M0WUT/kicad_libraries/dog-pngrepo-com.png

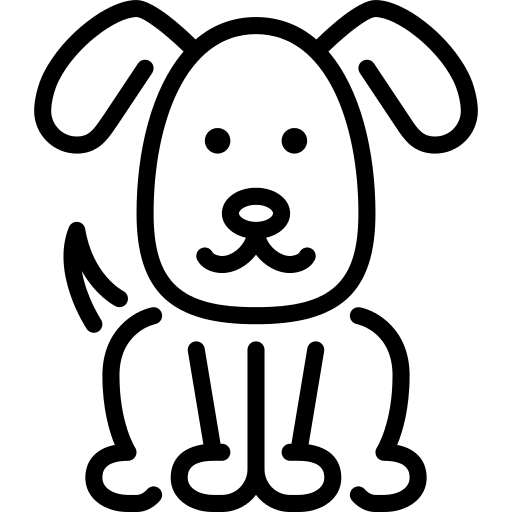
dog-pngrepo-com.png
