M0WUT/kicad_libraries/monocle.png

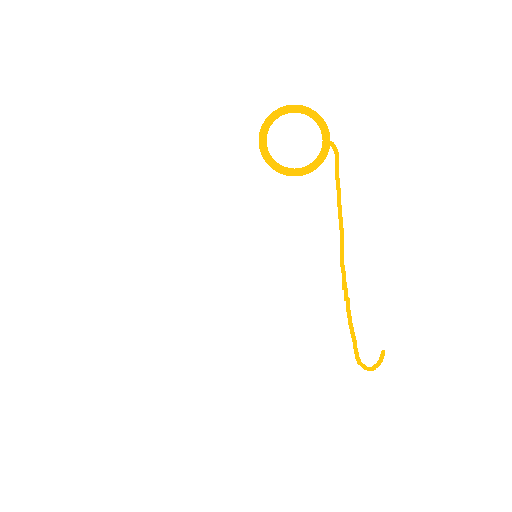
monocle.png
