M0WUT/kicad_libraries/scripts/autogenerated_parts.xlsx

Sheet: capacitor
Manufacturer | MPN | Value | Preferred | Package Description | Footprint | Max Height (mm) | Tolerance (%) | Datasheet | Polarised? | Voltage | Dielectric
Yageo | CC0402KRX7R8BB104 | 100n | Y | 0402 | Capacitor_SMD:C_0402_1005Metric | 0.5 | 10% | https://www.yageo.com/upload/media/product/productsearch/datasheet/mlcc/UPY-GPHC_X7R_6.3V-to-250V_23.pdf | N | 25V | X7R
Kyocera AVX | 12063D226KAT2A | 22u | N | 1206 | Capacitor_SMD:C_1206_3216Metric | 2.29 | 10% | https://www.farnell.com/datasheets/3673819.pdf | N | 25V | X5R
Kemet | C0603C100C3GACTU | 10p | N | 0603 | Capacitor_SMD:C_0603_1608Metric | 0.8 | 0.25pF | https://www.mouser.co.uk/datasheet/2/212/KEM_C1003_C0G_SMD-1101588.pdf | N | 25V | NP0/C0G
Kemet | C0603C151G1GACTU | 150p | N | 0603 | Capacitor_SMD:C_0603_1608Metric | 0.8 | 2% | https://www.mouser.co.uk/datasheet/2/212/KEM_C1003_C0G_SMD-1101588.pdf | N | 100V | NP0/C0G
Kemet | C0603C162F5GACTU | 1n6 | N | 0603 | Capacitor_SMD:C_0603_1608Metric | 0.8 | 1% | https://www.mouser.co.uk/datasheet/2/212/KEM_C1003_C0G_SMD-1101588.pdf | N | 50V | NP0/C0G
Kemet | C0603C202F5GACTU | 2n | N | 0603 | Capacitor_SMD:C_0603_1608Metric | 0.8 | 1% | https://www.mouser.co.uk/datasheet/2/212/KEM_C1003_C0G_SMD-1101588.pdf | N | 50V | NP0/C0G
Kemet | C0603C519C8GACTU | 5p1 | N | 0603 | Capacitor_SMD:C_0603_1608Metric | 0.8 | 0.25pF | https://www.mouser.co.uk/datasheet/2/212/KEM_C1003_C0G_SMD-1101588.pdf | N | 10V | NP0/C0G
Kemet | C0603C399J5GACTU | 3p9 | N | 0603 | Capacitor_SMD:C_0603_1608Metric | 0.8 | 5% | https://www.mouser.co.uk/datasheet/2/212/KEM_C1003_C0G_SMD-1101588.pdf | N | 50V | NP0/C0G
Kemet | C0603C510F1GACTU | 51p | N | 0603 | Capacitor_SMD:C_0603_1608Metric | 0.8 | 1% | https://www.mouser.co.uk/datasheet/2/212/KEM_C1003_C0G_SMD-1101588.pdf | N | 100V | NP0/C0G
Kemet | C0603C300F5GACTU | 30p | N | 0603 | Capacitor_SMD:C_0603_1608Metric | 0.8 | 1% | https://www.mouser.co.uk/datasheet/2/212/KEM_C1003_C0G_SMD-1101588.pdf | N | 50V | NP0/C0G
Kemet | C0603C430F5GACTU | 43p | N | 0603 | Capacitor_SMD:C_0603_1608Metric | 0.8 | 1% | https://www.mouser.co.uk/datasheet/2/212/KEM_C1003_C0G_SMD-1101588.pdf | N | 50V | NP0/C0G
Kemet | C0603C221G1GACTU | 220p | N | 0603 | Capacitor_SMD:C_0603_1608Metric | 0.8 | 2% | https://www.mouser.co.uk/datasheet/2/212/KEM_C1003_C0G_SMD-1101588.pdf | N | 100V | NP0/C0G
Kemet | C0603C471F1GACTU | 470p | N | 0603 | Capacitor_SMD:C_0603_1608Metric | 0.8 | 1% | https://www.mouser.co.uk/datasheet/2/212/KEM_C1003_C0G_SMD-1101588.pdf | N | 100V | NP0/C0G
Kemet | C0603C681F3GACTU | 680p | N | 0603 | Capacitor_SMD:C_0603_1608Metric | 0.8 | 1% | https://www.mouser.co.uk/datasheet/2/212/KEM_C1003_C0G_SMD-1101588.pdf | N | 25V | NP0/C0G
Kemet | C0603C122F1GACTU | 1n2 | N | 0603 | Capacitor_SMD:C_0603_1608Metric | 0.8 | 1% | https://www.mouser.co.uk/datasheet/2/212/KEM_C1003_C0G_SMD-1101588.pdf | N | 100V | NP0/C0G
Kemet | C0603C242F5GACTU | 2n4 | N | 0603 | Capacitor_SMD:C_0603_1608Metric | 0.8 | 1% | https://www.mouser.co.uk/datasheet/2/212/KEM_C1003_C0G_SMD-1101588.pdf | N | 50V | NP0/C0G
Kemet | C0603C470F1GACTU | 47p | N | 0603 | Capacitor_SMD:C_0603_1608Metric | 0.8 | 1% | https://www.mouser.co.uk/datasheet/2/212/KEM_C1003_C0G_SMD-1101588.pdf | N | 100V | NP0/C0G
Kemet | C0603C220K1GACTU | 22p | N | 0603 | Capacitor_SMD:C_0603_1608Metric | 0.8 | 10% | https://www.mouser.co.uk/datasheet/2/212/KEM_C1003_C0G_SMD-1101588.pdf | N | 100V | NP0/C0G
Kemet | C0603C200G5GACTU | 20p | N | 0603 | Capacitor_SMD:C_0603_1608Metric | 0.8 | 2% | https://www.mouser.co.uk/datasheet/2/212/KEM_C1003_C0G_SMD-1101588.pdf | N | 50V | NP0/C0G
Kemet | C0603C120C5GACTU | 12p | N | 0603 | Capacitor_SMD:C_0603_1608Metric | 0.8 | 0.25pF | https://www.mouser.co.uk/datasheet/2/212/KEM_C1003_C0G_SMD-1101588.pdf | N | 50V | NP0/C0G
Kemet | C0603C180C5GACTU | 18p | N | 0603 | Capacitor_SMD:C_0603_1608Metric | 0.8 | 0.25pF | https://www.mouser.co.uk/datasheet/2/212/KEM_C1003_C0G_SMD-1101588.pdf | N | 50V | NP0/C0G
Kemet | C0603C109B5GACTU | 1p | N | 0603 | Capacitor_SMD:C_0603_1608Metric | 0.8 | 0.1pF | https://www.mouser.co.uk/datasheet/2/212/KEM_C1003_C0G_SMD-1101588.pdf | N | 50V | NP0/C0G
Kemet | C0603C470J5GAC | 47p | N | 0603 | Capacitor_SMD:C_0603_1608Metric | 0.8 | 5% | https://www.mouser.co.uk/datasheet/2/212/KEM_C1003_C0G_SMD-1101588.pdf | N | 50V | NP0/C0G
Kemet | C0603C150G5GACTU | 15p | N | 0603 | Capacitor_SMD:C_0603_1608Metric | 0.8 | 2% | https://www.mouser.co.uk/datasheet/2/212/KEM_C1003_C0G_SMD-1101588.pdf | N | 50V | NP0/C0G
Kemet | C0603C221G3GACTU | 220p | N | 0603 | Capacitor_SMD:C_0603_1608Metric | 0.8 | 2% | https://www.mouser.co.uk/datasheet/2/212/KEM_C1003_C0G_SMD-1101588.pdf | N | 25V | NP0/C0G
Kemet | C0603C201F5GACTU | 200p | N | 0603 | Capacitor_SMD:C_0603_1608Metric | 0.8 | 1% | https://www.mouser.co.uk/datasheet/2/212/KEM_C1003_C0G_SMD-1101588.pdf | N | 50V | NP0/C0G
Kemet | C0603C431F5GACTU | 430p | N | 0603 | Capacitor_SMD:C_0603_1608Metric | 0.8 | 1% | https://www.mouser.co.uk/datasheet/2/212/KEM_C1003_C0G_SMD-1101588.pdf | N | 50V | NP0/C0G
Kemet | C0603C911F5GACTU | 910p | N | 0603 | Capacitor_SMD:C_0603_1608Metric | 0.8 | 1% | https://www.mouser.co.uk/datasheet/2/212/KEM_C1003_C0G_SMD-1101588.pdf | N | 50V | NP0/C0G
Kemet | C0603C621F5GACTU | 620p | N | 0603 | Capacitor_SMD:C_0603_1608Metric | 0.8 | 1% | https://www.mouser.co.uk/datasheet/2/212/KEM_C1003_C0G_SMD-1101588.pdf | N | 50V | NP0/C0G
Kemet | C0603C561F5GACTU | 560p | N | 0603 | Capacitor_SMD:C_0603_1608Metric | 0.8 | 1% | https://www.mouser.co.uk/datasheet/2/212/KEM_C1003_C0G_SMD-1101588.pdf | N | 50V | NP0/C0G
Kemet | C0603C391F5GACTU | 390p | N | 0603 | Capacitor_SMD:C_0603_1608Metric | 0.8 | 1% | https://www.mouser.co.uk/datasheet/2/212/KEM_C1003_C0G_SMD-1101588.pdf | N | 50V | NP0/C0G
Kemet | C0603C151F5GACTU | 150p | N | 0603 | Capacitor_SMD:C_0603_1608Metric | 0.8 | 1% | https://www.mouser.co.uk/datasheet/2/212/KEM_C1003_C0G_SMD-1101588.pdf | N | 50V | NP0/C0G
Kemet | C0603C752F3GACTU | 7n5 | N | 0603 | Capacitor_SMD:C_0603_1608Metric | 0.8 | 1% | https://www.mouser.co.uk/datasheet/2/212/KEM_C1003_C0G_SMD-1101588.pdf | N | 25V | NP0/C0G
Kemet | C0603C122J5GACTU | 1n2 | N | 0603 | Capacitor_SMD:C_0603_1608Metric | 0.8 | 5% | https://www.mouser.co.uk/datasheet/2/212/KEM_C1003_C0G_SMD-1101588.pdf | N | 50V | NP0/C0G
Kemet | C0603C103G3GACTU | 10n | N | 0603 | Capacitor_SMD:C_0603_1608Metric | 0.8 | 2% | https://www.mouser.co.uk/datasheet/2/212/KEM_C1003_C0G_SMD-1101588.pdf | N | 25V | NP0/C0G
Kemet | C0603C153G3GACTU | 15n | N | 0603 | Capacitor_SMD:C_0603_1608Metric | 0.8 | 2% | https://www.mouser.co.uk/datasheet/2/212/KEM_C1003_C0G_SMD-1101588.pdf | N | 25V | NP0/C0G
Kemet | C0603C392J3GACTU | 3n9 | N | 0603 | Capacitor_SMD:C_0603_1608Metric | 0.8 | 5% | https://www.mouser.co.uk/datasheet/2/212/KEM_C1003_C0G_SMD-1101588.pdf | N | 25V | NP0/C0G
Kemet | C0603C103F4GACTU | 10n | N | 0603 | Capacitor_SMD:C_0603_1608Metric | 0.8 | 1% | https://www.mouser.co.uk/datasheet/2/212/KEM_C1003_C0G_SMD-1101588.pdf | N | 16V | NP0/C0G
Kemet | C0603C103F3GACTU | 10n | N | 0603 | Capacitor_SMD:C_0603_1608Metric | 0.8 | 1% | https://www.mouser.co.uk/datasheet/2/212/KEM_C1003_C0G_SMD-1101588.pdf | N | 25V | NP0/C0G
Kemet | C0603C472J3GACTU | 4n7 | N | 0603 | Capacitor_SMD:C_0603_1608Metric | 0.8 | 5% | https://www.mouser.co.uk/datasheet/2/212/KEM_C1003_C0G_SMD-1101588.pdf | N | 25V | NP0/C0G
Kemet | C0603C472G5GACTU | 4n7 | N | 0603 | Capacitor_SMD:C_0603_1608Metric | 0.8 | 2% | https://www.mouser.co.uk/datasheet/2/212/KEM_C1003_C0G_SMD-1101588.pdf | N | 50V | NP0/C0G
Kemet | C0603C103J3GACTU | 10n | N | 0603 | Capacitor_SMD:C_0603_1608Metric | 0.8 | 5% | https://www.mouser.co.uk/datasheet/2/212/KEM_C1003_C0G_SMD-1101588.pdf | N | 25V | NP0/C0G
Kemet | C0603C362F5GACTU | 3n6 | N | 0603 | Capacitor_SMD:C_0603_1608Metric | 0.8 | 1% | https://www.mouser.co.uk/datasheet/2/212/KEM_C1003_C0G_SMD-1101588.pdf | N | 50V | NP0/C0G
Kemet | C0603C472F5GACTU | 4n7 | N | 0603 | Capacitor_SMD:C_0603_1608Metric | 0.8 | 1% | https://www.mouser.co.uk/datasheet/2/212/KEM_C1003_C0G_SMD-1101588.pdf | N | 50V | NP0/C0G
Kemet | C0603C472J5GACTU | 4n7 | N | 0603 | Capacitor_SMD:C_0603_1608Metric | 0.8 | 5% | https://www.mouser.co.uk/datasheet/2/212/KEM_C1003_C0G_SMD-1101588.pdf | N | 50V | NP0/C0G
Kemet | C0603C153F3GACTU | 15n | N | 0603 | Capacitor_SMD:C_0603_1608Metric | 0.8 | 1% | https://www.mouser.co.uk/datasheet/2/212/KEM_C1003_C0G_SMD-1101588.pdf | N | 25V | NP0/C0G
Kemet | C0603C102F4GACTU | 1n | N | 0603 | Capacitor_SMD:C_0603_1608Metric | 0.8 | 1% | https://www.mouser.co.uk/datasheet/2/212/KEM_C1003_C0G_SMD-1101588.pdf | N | 16V | NP0/C0G
Kemet | C0603C122F5GACTU | 1n2 | N | 0603 | Capacitor_SMD:C_0603_1608Metric | 0.8 | 1% | https://www.mouser.co.uk/datasheet/2/212/KEM_C1003_C0G_SMD-1101588.pdf | N | 50V | NP0/C0G
Kemet | C0603C432J5GACTU | 4n3 | N | 0603 | Capacitor_SMD:C_0603_1608Metric | 0.8 | 5% | https://www.mouser.co.uk/datasheet/2/212/KEM_C1003_C0G_SMD-1101588.pdf | N | 50V | NP0/C0G
Kemet | C0603C332F5GACTU | 3n3 | N | 0603 | Capacitor_SMD:C_0603_1608Metric | 0.8 | 1% | https://www.mouser.co.uk/datasheet/2/212/KEM_C1003_C0G_SMD-1101588.pdf | N | 50V | NP0/C0G
Kemet | C0603C222F1GACTU | 2n2 | N | 0603 | Capacitor_SMD:C_0603_1608Metric | 0.8 | 1% | https://www.mouser.co.uk/datasheet/2/212/KEM_C1003_C0G_SMD-1101588.pdf | N | 100V | NP0/C0G
Kemet | C0603C330KAGACTU | 33p | N | 0603 | Capacitor_SMD:C_0603_1608Metric | 0.8 | 10% | https://www.mouser.co.uk/datasheet/2/212/KEM_C1003_C0G_SMD-1101588.pdf | N | 250V | NP0/C0G
Kemet | C0603C360J4GACTU | 36p | N | 0603 | Capacitor_SMD:C_0603_1608Metric | 0.8 | 5% | https://www.mouser.co.uk/datasheet/2/212/KEM_C1003_C0G_SMD-1101588.pdf | N | 16V | NP0/C0G
Kemet | C0603C680K4GACTU | 68p | N | 0603 | Capacitor_SMD:C_0603_1608Metric | 0.8 | 10% | https://www.mouser.co.uk/datasheet/2/212/KEM_C1003_C0G_SMD-1101588.pdf | N | 16V | NP0/C0G
Kemet | C0603C689C3GACTU | 6p8 | N | 0603 | Capacitor_SMD:C_0603_1608Metric | 0.8 | 0.25pF | https://www.mouser.co.uk/datasheet/2/212/KEM_C1003_C0G_SMD-1101588.pdf | N | 25V | NP0/C0G
Kemet | C0603C150J3GAC7411 | 15p | N | 0603 | Capacitor_SMD:C_0603_1608Metric | 0.8 | 5% | https://www.mouser.co.uk/datasheet/2/212/KEM_C1003_C0G_SMD-1101588.pdf | N | 25V | NP0/C0G
Kemet | C0603C470G1GACTU | 47p | N | 0603 | Capacitor_SMD:C_0603_1608Metric | 0.8 | 2% | https://www.mouser.co.uk/datasheet/2/212/KEM_C1003_C0G_SMD-1101588.pdf | N | 100V | NP0/C0G
Kemet | C0603C369C5GACTU | 3p6 | N | 0603 | Capacitor_SMD:C_0603_1608Metric | 0.8 | 0.25pF | https://www.mouser.co.uk/datasheet/2/212/KEM_C1003_C0G_SMD-1101588.pdf | N | 50V | NP0/C0G
Kemet | C0603C820G3GACTU | 82p | N | 0603 | Capacitor_SMD:C_0603_1608Metric | 0.8 | 2% | https://www.mouser.co.uk/datasheet/2/212/KEM_C1003_C0G_SMD-1101588.pdf | N | 25V | NP0/C0G
Kemet | C0603C209C3GACTU | 2p | N | 0603 | Capacitor_SMD:C_0603_1608Metric | 0.8 | 0.25pF | https://www.mouser.co.uk/datasheet/2/212/KEM_C1003_C0G_SMD-1101588.pdf | N | 25V | NP0/C0G
Kemet | C0603C620F3GACTU | 62p | N | 0603 | Capacitor_SMD:C_0603_1608Metric | 0.8 | 1% | https://www.mouser.co.uk/datasheet/2/212/KEM_C1003_C0G_SMD-1101588.pdf | N | 25V | NP0/C0G
Kemet | C0603C300G5GACTU | 30p | N | 0603 | Capacitor_SMD:C_0603_1608Metric | 0.8 | 2% | https://www.mouser.co.uk/datasheet/2/212/KEM_C1003_C0G_SMD-1101588.pdf | N | 50V | NP0/C0G
Kemet | C0603C209D5GACTU | 2p | N | 0603 | Capacitor_SMD:C_0603_1608Metric | 0.8 | 0.5pF | https://www.mouser.co.uk/datasheet/2/212/KEM_C1003_C0G_SMD-1101588.pdf | N | 50V | NP0/C0G
Kemet | C0603C439K5GACTU | 4p3 | N | 0603 | Capacitor_SMD:C_0603_1608Metric | 0.8 | 10% | https://www.mouser.co.uk/datasheet/2/212/KEM_C1003_C0G_SMD-1101588.pdf | N | 50V | NP0/C0G
Kemet | C0603C180D3GACTU | 18p | N | 0603 | Capacitor_SMD:C_0603_1608Metric | 0.8 | 0.5pF | https://www.mouser.co.uk/datasheet/2/212/KEM_C1003_C0G_SMD-1101588.pdf | N | 25V | NP0/C0G
Kemet | C0603C470G5GACTU | 47p | N | 0603 | Capacitor_SMD:C_0603_1608Metric | 0.8 | 2% | https://www.mouser.co.uk/datasheet/2/212/KEM_C1003_C0G_SMD-1101588.pdf | N | 50V | NP0/C0G
Kemet | C0603C569C1GACTU | 5p6 | N | 0603 | Capacitor_SMD:C_0603_1608Metric | 0.8 | 0.25pF | https://www.mouser.co.uk/datasheet/2/212/KEM_C1003_C0G_SMD-1101588.pdf | N | 100V | NP0/C0G
Kemet | C0603C240J4GACTU | 24p | N | 0603 | Capacitor_SMD:C_0603_1608Metric | 0.8 | 5% | https://www.mouser.co.uk/datasheet/2/212/KEM_C1003_C0G_SMD-1101588.pdf | N | 16V | NP0/C0G
Kemet | C0603C829C3GACTU | 8p2 | N | 0603 | Capacitor_SMD:C_0603_1608Metric | 0.8 | 0.25pF | https://www.mouser.co.uk/datasheet/2/212/KEM_C1003_C0G_SMD-1101588.pdf | N | 25V | NP0/C0G
Kemet | C0603C139C5GACTU | 1p3 | N | 0603 | Capacitor_SMD:C_0603_1608Metric | 0.8 | 0.25pF | https://www.mouser.co.uk/datasheet/2/212/KEM_C1003_C0G_SMD-1101588.pdf | N | 50V | NP0/C0G
Kemet | C0603C750G5GACTU | 75p | N | 0603 | Capacitor_SMD:C_0603_1608Metric | 0.8 | 2% | https://www.mouser.co.uk/datasheet/2/212/KEM_C1003_C0G_SMD-1101588.pdf | N | 50V | NP0/C0G
Kemet | C0603C200C5GACTU | 20p | N | 0603 | Capacitor_SMD:C_0603_1608Metric | 0.8 | 0.25pF | https://www.mouser.co.uk/datasheet/2/212/KEM_C1003_C0G_SMD-1101588.pdf | N | 50V | NP0/C0G
Kemet | C0603C339C3GACTU | 3p3 | N | 0603 | Capacitor_SMD:C_0603_1608Metric | 0.8 | 0.25pF | https://www.mouser.co.uk/datasheet/2/212/KEM_C1003_C0G_SMD-1101588.pdf | N | 25V | NP0/C0G
Kemet | C0603C240C5GACTU | 24p | N | 0603 | Capacitor_SMD:C_0603_1608Metric | 0.8 | 0.25pF | https://www.mouser.co.uk/datasheet/2/212/KEM_C1003_C0G_SMD-1101588.pdf | N | 50V | NP0/C0G
Kemet | C0603C100K2GACTU | 10p | N | 0603 | Capacitor_SMD:C_0603_1608Metric | 0.8 | 10% | https://www.mouser.co.uk/datasheet/2/212/KEM_C1003_C0G_SMD-1101588.pdf | N | 200V | NP0/C0G
Kemet | C0603C220K1GAC7411 | 22p | N | 0603 | Capacitor_SMD:C_0603_1608Metric | 0.8 | 10% | https://www.mouser.co.uk/datasheet/2/212/KEM_C1003_C0G_SMD-1101588.pdf | N | 100V | NP0/C0G
Kemet | C0603C470F5GAC7411 | 47p | N | 0603 | Capacitor_SMD:C_0603_1608Metric | 0.8 | 1% | https://www.mouser.co.uk/datasheet/2/212/KEM_C1003_C0G_SMD-1101588.pdf | N | 50V | NP0/C0G
Kemet | C0603C479B5GACTU | 4p7 | N | 0603 | Capacitor_SMD:C_0603_1608Metric | 0.8 | 0.1pF | https://www.mouser.co.uk/datasheet/2/212/KEM_C1003_C0G_SMD-1101588.pdf | N | 50V | NP0/C0G
Kemet | C0603C180G1GACTU | 18p | N | 0603 | Capacitor_SMD:C_0603_1608Metric | 0.8 | 2% | https://www.mouser.co.uk/datasheet/2/212/KEM_C1003_C0G_SMD-1101588.pdf | N | 100V | NP0/C0G
Kemet | C0603C510G5GACTU | 51p | N | 0603 | Capacitor_SMD:C_0603_1608Metric | 0.8 | 2% | https://www.mouser.co.uk/datasheet/2/212/KEM_C1003_C0G_SMD-1101588.pdf | N | 50V | NP0/C0G
Kemet | C0603C689C8GACTU | 6p8 | N | 0603 | Capacitor_SMD:C_0603_1608Metric | 0.8 | 0.25pF | https://www.mouser.co.uk/datasheet/2/212/KEM_C1003_C0G_SMD-1101588.pdf | N | 10V | NP0/C0G
Kemet | C0603C240G3GACTU | 24p | N | 0603 | Capacitor_SMD:C_0603_1608Metric | 0.8 | 2% | https://www.mouser.co.uk/datasheet/2/212/KEM_C1003_C0G_SMD-1101588.pdf | N | 25V | NP0/C0G
Kemet | C0603C399B5GACTU | 3p9 | N | 0603 | Capacitor_SMD:C_0603_1608Metric | 0.8 | 0.1pF | https://www.mouser.co.uk/datasheet/2/212/KEM_C1003_C0G_SMD-1101588.pdf | N | 50V | NP0/C0G
Kemet | C0603C159C3GACTU | 1p5 | N | 0603 | Capacitor_SMD:C_0603_1608Metric | 0.8 | 0.25pF | https://www.mouser.co.uk/datasheet/2/212/KEM_C1003_C0G_SMD-1101588.pdf | N | 25V | NP0/C0G
Kemet | C0603C120D3GACTU | 12p | N | 0603 | Capacitor_SMD:C_0603_1608Metric | 0.8 | 0.5pF | https://www.mouser.co.uk/datasheet/2/212/KEM_C1003_C0G_SMD-1101588.pdf | N | 25V | NP0/C0G
Kemet | C0603C510K5GACTU | 51p | N | 0603 | Capacitor_SMD:C_0603_1608Metric | 0.8 | 10% | https://www.mouser.co.uk/datasheet/2/212/KEM_C1003_C0G_SMD-1101588.pdf | N | 50V | NP0/C0G
Kemet | C0603C909C5GACTU | 9p | N | 0603 | Capacitor_SMD:C_0603_1608Metric | 0.8 | 0.25pF | https://www.mouser.co.uk/datasheet/2/212/KEM_C1003_C0G_SMD-1101588.pdf | N | 50V | NP0/C0G
Kemet | C0603C470G4GACTU | 47p | N | 0603 | Capacitor_SMD:C_0603_1608Metric | 0.8 | 2% | https://www.mouser.co.uk/datasheet/2/212/KEM_C1003_C0G_SMD-1101588.pdf | N | 16V | NP0/C0G
Kemet | C0603C910G5GACTU | 91p | N | 0603 | Capacitor_SMD:C_0603_1608Metric | 0.8 | 2% | https://www.mouser.co.uk/datasheet/2/212/KEM_C1003_C0G_SMD-1101588.pdf | N | 50V | NP0/C0G
Kemet | C0603C119C5GACTU | 1p1 | N | 0603 | Capacitor_SMD:C_0603_1608Metric | 0.8 | 0.25pF | https://www.mouser.co.uk/datasheet/2/212/KEM_C1003_C0G_SMD-1101588.pdf | N | 50V | NP0/C0G
Kemet | C0603C200K3GACTU | 20p | N | 0603 | Capacitor_SMD:C_0603_1608Metric | 0.8 | 10% | https://www.mouser.co.uk/datasheet/2/212/KEM_C1003_C0G_SMD-1101588.pdf | N | 25V | NP0/C0G
Kemet | C0603C360F5GACTU | 36p | N | 0603 | Capacitor_SMD:C_0603_1608Metric | 0.8 | 1% | https://www.mouser.co.uk/datasheet/2/212/KEM_C1003_C0G_SMD-1101588.pdf | N | 50V | NP0/C0G
Kemet | C0603C470K8GACTU | 47p | N | 0603 | Capacitor_SMD:C_0603_1608Metric | 0.8 | 10% | https://www.mouser.co.uk/datasheet/2/212/KEM_C1003_C0G_SMD-1101588.pdf | N | 10V | NP0/C0G
Kemet | C0603C829J1GACTU | 8p2 | N | 0603 | Capacitor_SMD:C_0603_1608Metric | 0.8 | 5% | https://www.mouser.co.uk/datasheet/2/212/KEM_C1003_C0G_SMD-1101588.pdf | N | 100V | NP0/C0G
Kemet | C0603C121JAGACTU | 120p | N | 0603 | Capacitor_SMD:C_0603_1608Metric | 0.8 | 5% | https://www.mouser.co.uk/datasheet/2/212/KEM_C1003_C0G_SMD-1101588.pdf | N | 250V | NP0/C0G
Kemet | C0603C221K5GAC7411 | 220p | N | 0603 | Capacitor_SMD:C_0603_1608Metric | 0.8 | 10% | https://www.mouser.co.uk/datasheet/2/212/KEM_C1003_C0G_SMD-1101588.pdf | N | 50V | NP0/C0G
Kemet | C0603C391G5GACTU | 390p | N | 0603 | Capacitor_SMD:C_0603_1608Metric | 0.8 | 2% | https://www.mouser.co.uk/datasheet/2/212/KEM_C1003_C0G_SMD-1101588.pdf | N | 50V | NP0/C0G
Kemet | C0603C751G5GACTU | 750p | N | 0603 | Capacitor_SMD:C_0603_1608Metric | 0.8 | 2% | https://www.mouser.co.uk/datasheet/2/212/KEM_C1003_C0G_SMD-1101588.pdf | N | 50V | NP0/C0G
Kemet | C0603C151J2GACTU | 150p | N | 0603 | Capacitor_SMD:C_0603_1608Metric | 0.8 | 5% | https://www.mouser.co.uk/datasheet/2/212/KEM_C1003_C0G_SMD-1101588.pdf | N | 200V | NP0/C0G
Kemet | C0603C471J4GACTU | 470p | N | 0603 | Capacitor_SMD:C_0603_1608Metric | 0.8 | 5% | https://www.mouser.co.uk/datasheet/2/212/KEM_C1003_C0G_SMD-1101588.pdf | N | 16V | NP0/C0G
Kemet | C0603C511K5GACTU | 510p | N | 0603 | Capacitor_SMD:C_0603_1608Metric | 0.8 | 10% | https://www.mouser.co.uk/datasheet/2/212/KEM_C1003_C0G_SMD-1101588.pdf | N | 50V | NP0/C0G
Kemet | C0603C361JAGACTU | 360p | N | 0603 | Capacitor_SMD:C_0603_1608Metric | 0.8 | 5% | https://www.mouser.co.uk/datasheet/2/212/KEM_C1003_C0G_SMD-1101588.pdf | N | 250V | NP0/C0G
Kemet | C0603C151J4GACTU | 150p | N | 0603 | Capacitor_SMD:C_0603_1608Metric | 0.8 | 5% | https://www.mouser.co.uk/datasheet/2/212/KEM_C1003_C0G_SMD-1101588.pdf | N | 16V | NP0/C0G
Kemet | C0603C331F3GACTU | 330p | N | 0603 | Capacitor_SMD:C_0603_1608Metric | 0.8 | 1% | https://www.mouser.co.uk/datasheet/2/212/KEM_C1003_C0G_SMD-1101588.pdf | N | 25V | NP0/C0G
Kemet | C0603C391K1GACTU | 390p | N | 0603 | Capacitor_SMD:C_0603_1608Metric | 0.8 | 10% | https://www.mouser.co.uk/datasheet/2/212/KEM_C1003_C0G_SMD-1101588.pdf | N | 100V | NP0/C0G
Kemet | C0603C131F5GACTU | 130p | N | 0603 | Capacitor_SMD:C_0603_1608Metric | 0.8 | 1% | https://www.mouser.co.uk/datasheet/2/212/KEM_C1003_C0G_SMD-1101588.pdf | N | 50V | NP0/C0G
Kemet | C0603C621K5GACTU | 620p | N | 0603 | Capacitor_SMD:C_0603_1608Metric | 0.8 | 10% | https://www.mouser.co.uk/datasheet/2/212/KEM_C1003_C0G_SMD-1101588.pdf | N | 50V | NP0/C0G
Kemet | C0603C511J1GACTU | 510p | N | 0603 | Capacitor_SMD:C_0603_1608Metric | 0.8 | 5% | https://www.mouser.co.uk/datasheet/2/212/KEM_C1003_C0G_SMD-1101588.pdf | N | 100V | NP0/C0G
Kemet | C0603C121F1GACTU | 120p | N | 0603 | Capacitor_SMD:C_0603_1608Metric | 0.8 | 1% | https://www.mouser.co.uk/datasheet/2/212/KEM_C1003_C0G_SMD-1101588.pdf | N | 100V | NP0/C0G
Kemet | C0603C471F3GACTU | 470p | N | 0603 | Capacitor_SMD:C_0603_1608Metric | 0.8 | 1% | https://www.mouser.co.uk/datasheet/2/212/KEM_C1003_C0G_SMD-1101588.pdf | N | 25V | NP0/C0G
Kemet | C0603C111K5GACTU | 110p | N | 0603 | Capacitor_SMD:C_0603_1608Metric | 0.8 | 10% | https://www.mouser.co.uk/datasheet/2/212/KEM_C1003_C0G_SMD-1101588.pdf | N | 50V | NP0/C0G
Kemet | C0603C471J8GACTU | 470p | N | 0603 | Capacitor_SMD:C_0603_1608Metric | 0.8 | 5% | https://www.mouser.co.uk/datasheet/2/212/KEM_C1003_C0G_SMD-1101588.pdf | N | 10V | NP0/C0G
Kemet | C0603C241K2GACTU | 240p | N | 0603 | Capacitor_SMD:C_0603_1608Metric | 0.8 | 10% | https://www.mouser.co.uk/datasheet/2/212/KEM_C1003_C0G_SMD-1101588.pdf | N | 200V | NP0/C0G
Kemet | C0603C511F4GACTU | 510p | N | 0603 | Capacitor_SMD:C_0603_1608Metric | 0.8 | 1% | https://www.mouser.co.uk/datasheet/2/212/KEM_C1003_C0G_SMD-1101588.pdf | N | 16V | NP0/C0G
Kemet | C0603C271J2GACTU | 270p | N | 0603 | Capacitor_SMD:C_0603_1608Metric | 0.8 | 5% | https://www.mouser.co.uk/datasheet/2/212/KEM_C1003_C0G_SMD-1101588.pdf | N | 200V | NP0/C0G
Kemet | C0603C101F4GAC | 100p | N | 0603 | Capacitor_SMD:C_0603_1608Metric | 0.8 | 1% | https://www.mouser.co.uk/datasheet/2/212/KEM_C1003_C0G_SMD-1101588.pdf | N | 16V | NP0/C0G
Kemet | C0603C561G5GACTU | 560p | N | 0603 | Capacitor_SMD:C_0603_1608Metric | 0.8 | 2% | https://www.mouser.co.uk/datasheet/2/212/KEM_C1003_C0G_SMD-1101588.pdf | N | 50V | NP0/C0G
Kemet | C0603C271J5GAC7411 | 270p | N | 0603 | Capacitor_SMD:C_0603_1608Metric | 0.8 | 5% | https://www.mouser.co.uk/datasheet/2/212/KEM_C1003_C0G_SMD-1101588.pdf | N | 50V | NP0/C0G
Kemet | C0603C821J2GACTU | 820p | N | 0603 | Capacitor_SMD:C_0603_1608Metric | 0.8 | 5% | https://www.mouser.co.uk/datasheet/2/212/KEM_C1003_C0G_SMD-1101588.pdf | N | 200V | NP0/C0G
Kemet | C0603C471GAGACTU | 470p | N | 0603 | Capacitor_SMD:C_0603_1608Metric | 0.8 | 2% | https://www.mouser.co.uk/datasheet/2/212/KEM_C1003_C0G_SMD-1101588.pdf | N | 250V | NP0/C0G
Kemet | C0603C271G2GACTU | 270p | N | 0603 | Capacitor_SMD:C_0603_1608Metric | 0.8 | 2% | https://www.mouser.co.uk/datasheet/2/212/KEM_C1003_C0G_SMD-1101588.pdf | N | 200V | NP0/C0G
Kemet | C0603C361F3GACTU | 360p | N | 0603 | Capacitor_SMD:C_0603_1608Metric | 0.8 | 1% | https://www.mouser.co.uk/datasheet/2/212/KEM_C1003_C0G_SMD-1101588.pdf | N | 25V | NP0/C0G
Kemet | C0603C301JAGACTU | 300p | N | 0603 | Capacitor_SMD:C_0603_1608Metric | 0.8 | 5% | https://www.mouser.co.uk/datasheet/2/212/KEM_C1003_C0G_SMD-1101588.pdf | N | 250V | NP0/C0G
Kemet | C0603C111G5GACTU | 110p | N | 0603 | Capacitor_SMD:C_0603_1608Metric | 0.8 | 2% | https://www.mouser.co.uk/datasheet/2/212/KEM_C1003_C0G_SMD-1101588.pdf | N | 50V | NP0/C0G
Kemet | C0603C181G5GACTU | 180p | N | 0603 | Capacitor_SMD:C_0603_1608Metric | 0.8 | 2% | https://www.mouser.co.uk/datasheet/2/212/KEM_C1003_C0G_SMD-1101588.pdf | N | 50V | NP0/C0G
Kemet | C0603C431G5GACTU | 430p | N | 0603 | Capacitor_SMD:C_0603_1608Metric | 0.8 | 2% | https://www.mouser.co.uk/datasheet/2/212/KEM_C1003_C0G_SMD-1101588.pdf | N | 50V | NP0/C0G
Kemet | C0603C621JAGACTU | 620p | N | 0603 | Capacitor_SMD:C_0603_1608Metric | 0.8 | 5% | https://www.mouser.co.uk/datasheet/2/212/KEM_C1003_C0G_SMD-1101588.pdf | N | 250V | NP0/C0G
Kyocera AVX | 06033D105KAT2A | 1u | N | 0603 | Capacitor_SMD:C_0603_1608Metric | 0.95 | 10% | https://www.mouser.co.uk/datasheet/2/40/cx5r_KGM-3223198.pdf | N | 25V | X5R
Samsung Electro-Mechanics | CL10A106MO8NQNC | 10u | Y | 0603 | Capacitor_SMD:C_0603_1608Metric | 0.9 | 20% | https://www.mouser.co.uk/datasheet/2/585/MLCC-1837944.pdf | N | 16V | X5R
Wurth Elektronik | 875115952001 | 6u8 | N | 8x8.7mm | Capacitor_WUT:Wurth_WCAP_PSHP_8x8.7mm_SM | 8.7 | 20% | https://www.we-online.com/components/products/datasheet/875115952001.pdf | Y | 100V | Aluminium Polymer
Wurth Elektronik | 875116152001 | 10u | N | 8x8.7mm | Capacitor_WUT:Wurth_WCAP_PSHP_8x8.7mm_SM | 8.7 | 20% | https://www.we-online.com/components/products/datasheet/875116152001.pdf | Y | 80V | Aluminium Polymer
Wurth Elektronik | 875115752001 | 10u | N | 8x8.7mm | Capacitor_WUT:Wurth_WCAP_PSHP_8x8.7mm_SM | 8.7 | 20% | https://www.we-online.com/components/products/datasheet/875115752001.pdf | Y | 50V | Aluminium Polymer
Wurth Elektronik | 875115852001 | 10u | N | 8x8.7mm | Capacitor_WUT:Wurth_WCAP_PSHP_8x8.7mm_SM | 8.7 | 20% | https://www.we-online.com/components/products/datasheet/875115852001.pdf | Y | 63V | Aluminium Polymer
Wurth Elektronik | 875115655011 | 22u | N | 8x11.7mm | Capacitor_WUT:Wurth_WCAP_PSHP_8x11.7mm_SM | 11.7 | 20% | https://www.we-online.com/components/products/datasheet/875115655011.pdf | Y | 35V | Aluminium Polymer
Wurth Elektronik | 875115655013 | 33u | N | 8x11.7mm | Capacitor_WUT:Wurth_WCAP_PSHP_8x11.7mm_SM | 11.7 | 20% | https://www.we-online.com/components/products/datasheet/875115655013.pdf | Y | 35V | Aluminium Polymer
Wurth Elektronik | 875115652014 | 39u | N | 8x8.7mm | Capacitor_WUT:Wurth_WCAP_PSHP_8x8.7mm_SM | 8.7 | 20% | https://www.we-online.com/components/products/datasheet/875115652014.pdf | Y | 35V | Aluminium Polymer
Wurth Elektronik | 875115650005 | 56u | N | 8x7.7mm | Capacitor_WUT:Wurth_WCAP_PSHP_8x7.7mm_SM | 7.7 | 20% | https://www.we-online.com/components/products/datasheet/875115650005.pdf | Y | 35V | Aluminium Polymer
Wurth Elektronik | 875115655015 | 56u | N | 8x11.7mm | Capacitor_WUT:Wurth_WCAP_PSHP_8x11.7mm_SM | 11.7 | 20% | https://www.we-online.com/components/products/datasheet/875115655015.pdf | Y | 35V | Aluminium Polymer
Wurth Elektronik | 875115452001 | 68u | N | 8x8.7mm | Capacitor_WUT:Wurth_WCAP_PSHP_8x8.7mm_SM | 8.7 | 20% | https://www.we-online.com/components/products/datasheet/875115452001.pdf | Y | 20V | Aluminium Polymer
Wurth Elektronik | 875115552001 | 68u | N | 8x8.7mm | Capacitor_WUT:Wurth_WCAP_PSHP_8x8.7mm_SM | 8.7 | 20% | https://www.we-online.com/components/products/datasheet/875115552001.pdf | Y | 25V | Aluminium Polymer
Wurth Elektronik | 875115452002 | 82u | N | 8x8.7mm | Capacitor_WUT:Wurth_WCAP_PSHP_8x8.7mm_SM | 8.7 | 20% | https://www.we-online.com/components/products/datasheet/875115452002.pdf | Y | 20V | Aluminium Polymer
Wurth Elektronik | 875115552002 | 82u | N | 8x8.7mm | Capacitor_WUT:Wurth_WCAP_PSHP_8x8.7mm_SM | 8.7 | 20% | https://www.we-online.com/components/products/datasheet/875115552002.pdf | Y | 25V | Aluminium Polymer
Wurth Elektronik | 875115652006 | 82u | N | 8x8.7mm | Capacitor_WUT:Wurth_WCAP_PSHP_8x8.7mm_SM | 8.7 | 20% | https://www.we-online.com/components/products/datasheet/875115652006.pdf | Y | 35V | Aluminium Polymer
Wurth Elektronik | 875115452003 | 100u | N | 8x8.7mm | Capacitor_WUT:Wurth_WCAP_PSHP_8x8.7mm_SM | 8.7 | 20% | https://www.we-online.com/components/products/datasheet/875115452003.pdf | Y | 20V | Aluminium Polymer
Wurth Elektronik | 875115652007 | 100u | N | 8x8.7mm | Capacitor_WUT:Wurth_WCAP_PSHP_8x8.7mm_SM | 8.7 | 20% | https://www.we-online.com/components/products/datasheet/875115652007.pdf | Y | 35V | Aluminium Polymer
Wurth Elektronik | 875115655003 | 100u | N | 8x11.7mm | Capacitor_WUT:Wurth_WCAP_PSHP_8x11.7mm_SM | 11.7 | 20% | https://www.we-online.com/components/products/datasheet/875115655003.pdf | Y | 35V | Aluminium Polymer
Wurth Elektronik | 875115452004 | 150u | N | 8x8.7mm | Capacitor_WUT:Wurth_WCAP_PSHP_8x8.7mm_SM | 8.7 | 20% | https://www.we-online.com/components/products/datasheet/875115452004.pdf | Y | 20V | Aluminium Polymer
Wurth Elektronik | 875115350001 | 180u | N | 8x7.7mm | Capacitor_WUT:Wurth_WCAP_PSHP_8x7.7mm_SM | 7.7 | 20% | https://www.we-online.com/components/products/datasheet/875115350001.pdf | Y | 16V | Aluminium Polymer
Wurth Elektronik | 875115150001 | 220u | N | 8x7.7mm | Capacitor_WUT:Wurth_WCAP_PSHP_8x7.7mm_SM | 7.7 | 20% | https://www.we-online.com/components/products/datasheet/875115150001.pdf | Y | 6V3 | Aluminium Polymer
Wurth Elektronik | 875115350002 | 220u | N | 8x7.7mm | Capacitor_WUT:Wurth_WCAP_PSHP_8x7.7mm_SM | 7.7 | 20% | https://www.we-online.com/components/products/datasheet/875115350002.pdf | Y | 16V | Aluminium Polymer
Wurth Elektronik | 875115150002 | 270u | N | 8x7.7mm | Capacitor_WUT:Wurth_WCAP_PSHP_8x7.7mm_SM | 7.7 | 20% | https://www.we-online.com/components/products/datasheet/875115150002.pdf | Y | 6V3 | Aluminium Polymer
Wurth Elektronik | 875115352003 | 270u | N | 8x8.7mm | Capacitor_WUT:Wurth_WCAP_PSHP_8x8.7mm_SM | 8.7 | 20% | https://www.we-online.com/components/products/datasheet/875115352003.pdf | Y | 16V | Aluminium Polymer
Wurth Elektronik | 875115150003 | 330u | N | 8x7.7mm | Capacitor_WUT:Wurth_WCAP_PSHP_8x7.7mm_SM | 7.7 | 20% | https://www.we-online.com/components/products/datasheet/875115150003.pdf | Y | 6V3 | Aluminium Polymer
Wurth Elektronik | 875115250001 | 330u | N | 8x7.7mm | Capacitor_WUT:Wurth_WCAP_PSHP_8x7.7mm_SM | 7.7 | 20% | https://www.we-online.com/components/products/datasheet/875115250001.pdf | Y | 10V | Aluminium Polymer
Wurth Elektronik | 875115150004 | 390u | N | 8x7.7mm | Capacitor_WUT:Wurth_WCAP_PSHP_8x7.7mm_SM | 7.7 | 20% | https://www.we-online.com/components/products/datasheet/875115150004.pdf | Y | 6V3 | Aluminium Polymer
Wurth Elektronik | 875115250002 | 390u | N | 8x7.7mm | Capacitor_WUT:Wurth_WCAP_PSHP_8x7.7mm_SM | 7.7 | 20% | https://www.we-online.com/components/products/datasheet/875115250002.pdf | Y | 10V | Aluminium Polymer
Wurth Elektronik | 875115150005 | 470u | N | 8x7.7mm | Capacitor_WUT:Wurth_WCAP_PSHP_8x7.7mm_SM | 7.7 | 20% | https://www.we-online.com/components/products/datasheet/875115150005.pdf | Y | 6V3 | Aluminium Polymer
Wurth Elektronik | 875115252003 | 470u | N | 8x8.7mm | Capacitor_WUT:Wurth_WCAP_PSHP_8x8.7mm_SM | 8.7 | 20% | https://www.we-online.com/components/products/datasheet/875115252003.pdf | Y | 10V | Aluminium Polymer
Wurth Elektronik | 875115152006 | 560u | N | 8x8.7mm | Capacitor_WUT:Wurth_WCAP_PSHP_8x8.7mm_SM | 8.7 | 20% | https://www.we-online.com/components/products/datasheet/875115152006.pdf | Y | 6V3 | Aluminium Polymer
Wurth Elektronik | 875115152007 | 680u | N | 8x8.7mm | Capacitor_WUT:Wurth_WCAP_PSHP_8x8.7mm_SM | 8.7 | 20% | https://www.we-online.com/components/products/datasheet/875115152007.pdf | Y | 6V3 | Aluminium Polymer
Kyocera AVX | 06035C104KAT2A | 100n | N | 0603 | Capacitor_SMD:C_0603_1608Metric | 0.95 | 10% | https://www.mouser.co.uk/datasheet/2/40/KGM_X7R-3223212.pdf | N | 50V | X7R
Wurth Elektronik | 875575853003 | 33u | N | 8x10.5mm | Capacitor_WUT:Wurth_WCAP-HSG5_8x10.5mm_SM | 10.5 | 20% | https://www.we-online.com/components/products/datasheet/875575853003.pdf | Y | 63V | Aluminium Hybrid Polymer
Wurth Elektronik | 875575853004 | 47u | N | 8x10.5mm | Capacitor_WUT:Wurth_WCAP-HSG5_8x10.5mm_SM | 10.5 | 20% | https://www.we-online.com/components/products/datasheet/875575853004.pdf | Y | 63V | Aluminium Hybrid Polymer
Wurth Elektronik | 875575753005 | 68u | N | 8x10.5mm | Capacitor_WUT:Wurth_WCAP-HSG5_8x10.5mm_SM | 10.5 | 20% | https://www.we-online.com/components/products/datasheet/875575753005.pdf | Y | 50V | Aluminium Hybrid Polymer
Wurth Elektronik | 875575553004 | 220u | N | 8x10.5mm | Capacitor_WUT:Wurth_WCAP-HSG5_8x10.5mm_SM | 10.5 | 20% | https://www.we-online.com/components/products/datasheet/875575553004.pdf | Y | 25V | Aluminium Hybrid Polymer
Wurth Elektronik | 875585561007 | 470u | N | 10x12.4mm | Wurth_WCAP-HSAH_10x12.4mm_SM | 12.4 | 20% | https://www.we-online.com/components/products/datasheet/875585561007.pdf | Y | 25V | Aluminium Hybrid Polymer
Kemet | C0402C309K4GACTU | 3p | N | 0402 | Capacitor_SMD:C_0402_1005Metric | 0.5 | 10% | https://www.mouser.co.uk/datasheet/2/447/KEM_C1006_X5R_SMD-3316465.pdf | N | 16V | NP0/C0G
Kemet | C0402C561F5GACTU | 560p | N | 0402 | Capacitor_SMD:C_0402_1005Metric | 0.5 | 1% | https://www.mouser.co.uk/datasheet/2/447/KEM_C1006_X5R_SMD-3316465.pdf | N | 50V | NP0/C0G
Kemet | C0402C102F8GACTU | 1n | N | 0402 | Capacitor_SMD:C_0402_1005Metric | 0.5 | 1% | https://www.mouser.co.uk/datasheet/2/447/KEM_C1006_X5R_SMD-3316465.pdf | N | 10V | NP0/C0G
Kemet | C0402C120F5GACTU | 12p | N | 0402 | Capacitor_SMD:C_0402_1005Metric | 0.5 | 1% | https://www.mouser.co.uk/datasheet/2/447/KEM_C1006_X5R_SMD-3316465.pdf | N | 50V | NP0/C0G
Kemet | C0402C620J3GACTU | 62p | N | 0402 | Capacitor_SMD:C_0402_1005Metric | 0.5 | 2% | https://www.mouser.co.uk/datasheet/2/447/KEM_C1006_X5R_SMD-3316465.pdf | N | 25V | NP0/C0G
Kemet | C0402C561K8GACTU | 560p | N | 0402 | Capacitor_SMD:C_0402_1005Metric | 0.5 | 10% | https://www.mouser.co.uk/datasheet/2/447/KEM_C1006_X5R_SMD-3316465.pdf | N | 10V | NP0/C0G
Kemet | C0402C182F4GACTU | 1n8 | N | 0402 | Capacitor_SMD:C_0402_1005Metric | 0.5 | 1% | https://www.mouser.co.uk/datasheet/2/447/KEM_C1006_X5R_SMD-3316465.pdf | N | 16V | NP0/C0G
Kemet | C0402C102F4GACTU | 1n | N | 0402 | Capacitor_SMD:C_0402_1005Metric | 0.5 | 1% | https://www.mouser.co.uk/datasheet/2/447/KEM_C1006_X5R_SMD-3316465.pdf | N | 16V | NP0/C0G
Kemet | C0402C132J5GACTU | 1n3 | N | 0402 | Capacitor_SMD:C_0402_1005Metric | 0.5 | 2% | https://www.mouser.co.uk/datasheet/2/447/KEM_C1006_X5R_SMD-3316465.pdf | N | 50V | NP0/C0G
Kemet | C0402C101J8GACTU | 100p | N | 0402 | Capacitor_SMD:C_0402_1005Metric | 0.5 | 2% | https://www.mouser.co.uk/datasheet/2/447/KEM_C1006_X5R_SMD-3316465.pdf | N | 10V | NP0/C0G
Kemet | C0402C301J3GACTU | 300p | N | 0402 | Capacitor_SMD:C_0402_1005Metric | 0.5 | 2% | https://www.mouser.co.uk/datasheet/2/447/KEM_C1006_X5R_SMD-3316465.pdf | N | 25V | NP0/C0G
Kemet | C0402C331G5GACTU | 330p | N | 0402 | Capacitor_SMD:C_0402_1005Metric | 0.5 | 2% | https://www.mouser.co.uk/datasheet/2/447/KEM_C1006_X5R_SMD-3316465.pdf | N | 50V | NP0/C0G
Kemet | C0402C180F5GACTU | 18p | N | 0402 | Capacitor_SMD:C_0402_1005Metric | 0.5 | 1% | https://www.mouser.co.uk/datasheet/2/447/KEM_C1006_X5R_SMD-3316465.pdf | N | 50V | NP0/C0G
Kemet | C0402C129D3GACTU | 1p2 | N | 0402 | Capacitor_SMD:C_0402_1005Metric | 0.5 | 0.5pF | https://www.mouser.co.uk/datasheet/2/447/KEM_C1006_X5R_SMD-3316465.pdf | N | 25V | NP0/C0G
Kemet | C0402C821J1GACTU | 820p | N | 0402 | Capacitor_SMD:C_0402_1005Metric | 0.5 | 2% | https://www.mouser.co.uk/datasheet/2/447/KEM_C1006_X5R_SMD-3316465.pdf | N | 100V | NP0/C0G
Kemet | C0402C152G5GACTU | 1n5 | N | 0402 | Capacitor_SMD:C_0402_1005Metric | 0.5 | 2% | https://www.mouser.co.uk/datasheet/2/447/KEM_C1006_X5R_SMD-3316465.pdf | N | 50V | NP0/C0G
Kemet | C0402C106M7PACTU | 10u | N | 0402 | Capacitor_SMD:C_0402_1005Metric | 0.5 | 20% | https://www.mouser.co.uk/datasheet/2/447/KEM_C1006_X5R_SMD-3316465.pdf | N | 4V | X5R
Kemet | C0402C300G5GACTU | 30p | N | 0402 | Capacitor_SMD:C_0402_1005Metric | 0.5 | 2% | https://www.mouser.co.uk/datasheet/2/447/KEM_C1006_X5R_SMD-3316465.pdf | N | 50V | NP0/C0G
Kemet | C0402C809B5GACTU | 8p | N | 0402 | Capacitor_SMD:C_0402_1005Metric | 0.5 | 0.1pF | https://www.mouser.co.uk/datasheet/2/447/KEM_C1006_X5R_SMD-3316465.pdf | N | 50V | NP0/C0G
Kemet | C0402C201G5GACTU | 200p | N | 0402 | Capacitor_SMD:C_0402_1005Metric | 0.5 | 2% | https://www.mouser.co.uk/datasheet/2/447/KEM_C1006_X5R_SMD-3316465.pdf | N | 50V | NP0/C0G
Kemet | C0402C120K3GACTU | 12p | N | 0402 | Capacitor_SMD:C_0402_1005Metric | 0.5 | 10% | https://www.mouser.co.uk/datasheet/2/447/KEM_C1006_X5R_SMD-3316465.pdf | N | 25V | NP0/C0G
Kemet | C0402C439B5GACTU | 4p3 | N | 0402 | Capacitor_SMD:C_0402_1005Metric | 0.5 | 0.1pF | https://www.mouser.co.uk/datasheet/2/447/KEM_C1006_X5R_SMD-3316465.pdf | N | 50V | NP0/C0G
Kemet | C0402C391K5GACTU | 390p | N | 0402 | Capacitor_SMD:C_0402_1005Metric | 0.5 | 10% | https://www.mouser.co.uk/datasheet/2/447/KEM_C1006_X5R_SMD-3316465.pdf | N | 50V | NP0/C0G
Kemet | C0402C240G5GACTU | 24p | N | 0402 | Capacitor_SMD:C_0402_1005Metric | 0.5 | 2% | https://www.mouser.co.uk/datasheet/2/447/KEM_C1006_X5R_SMD-3316465.pdf | N | 50V | NP0/C0G
Kemet | C0402C222F3GACTU | 2n2 | N | 0402 | Capacitor_SMD:C_0402_1005Metric | 0.5 | 1% | https://www.mouser.co.uk/datasheet/2/447/KEM_C1006_X5R_SMD-3316465.pdf | N | 25V | NP0/C0G
Kemet | C0402C120K4GACTU | 12p | N | 0402 | Capacitor_SMD:C_0402_1005Metric | 0.5 | 10% | https://www.mouser.co.uk/datasheet/2/447/KEM_C1006_X5R_SMD-3316465.pdf | N | 16V | NP0/C0G
Kemet | C0402C561J1GACTU | 560p | N | 0402 | Capacitor_SMD:C_0402_1005Metric | 0.5 | 2% | https://www.mouser.co.uk/datasheet/2/447/KEM_C1006_X5R_SMD-3316465.pdf | N | 100V | NP0/C0G
Kemet | C0402C209B5GACTU | 2p | N | 0402 | Capacitor_SMD:C_0402_1005Metric | 0.5 | 0.1pF | https://www.mouser.co.uk/datasheet/2/447/KEM_C1006_X5R_SMD-3316465.pdf | N | 50V | NP0/C0G
Kemet | C0402C182J3GACTU | 1n8 | N | 0402 | Capacitor_SMD:C_0402_1005Metric | 0.5 | 2% | https://www.mouser.co.uk/datasheet/2/447/KEM_C1006_X5R_SMD-3316465.pdf | N | 25V | NP0/C0G
Kemet | C0402C222J4GACTU | 2n2 | N | 0402 | Capacitor_SMD:C_0402_1005Metric | 0.5 | 2% | https://www.mouser.co.uk/datasheet/2/447/KEM_C1006_X5R_SMD-3316465.pdf | N | 16V | NP0/C0G
Kemet | C0402C919B5GACTU | 9p1 | N | 0402 | Capacitor_SMD:C_0402_1005Metric | 0.5 | 0.1pF | https://www.mouser.co.uk/datasheet/2/447/KEM_C1006_X5R_SMD-3316465.pdf | N | 50V | NP0/C0G
Kemet | C0402C102K1GACTU | 1n | N | 0402 | Capacitor_SMD:C_0402_1005Metric | 0.5 | 10% | https://www.mouser.co.uk/datasheet/2/447/KEM_C1006_X5R_SMD-3316465.pdf | N | 100V | NP0/C0G
Kemet | C0402C150C5GACTU | 15p | N | 0402 | Capacitor_SMD:C_0402_1005Metric | 0.5 | 0.25pF | https://www.mouser.co.uk/datasheet/2/447/KEM_C1006_X5R_SMD-3316465.pdf | N | 50V | NP0/C0G
Kemet | C0402C100J8GACTU | 10p | N | 0402 | Capacitor_SMD:C_0402_1005Metric | 0.5 | 2% | https://www.mouser.co.uk/datasheet/2/447/KEM_C1006_X5R_SMD-3316465.pdf | N | 10V | NP0/C0G
Kemet | C0402C820F5GACTU | 82p | N | 0402 | Capacitor_SMD:C_0402_1005Metric | 0.5 | 1% | https://www.mouser.co.uk/datasheet/2/447/KEM_C1006_X5R_SMD-3316465.pdf | N | 50V | NP0/C0G
Kemet | C0402C300F5GACTU | 30p | N | 0402 | Capacitor_SMD:C_0402_1005Metric | 0.5 | 1% | https://www.mouser.co.uk/datasheet/2/447/KEM_C1006_X5R_SMD-3316465.pdf | N | 50V | NP0/C0G
Kemet | C0402C471F5GACTU | 470p | N | 0402 | Capacitor_SMD:C_0402_1005Metric | 0.5 | 1% | https://www.mouser.co.uk/datasheet/2/447/KEM_C1006_X5R_SMD-3316465.pdf | N | 50V | NP0/C0G
Kemet | C0402C161J5GACTU | 160p | N | 0402 | Capacitor_SMD:C_0402_1005Metric | 0.5 | 2% | https://www.mouser.co.uk/datasheet/2/447/KEM_C1006_X5R_SMD-3316465.pdf | N | 50V | NP0/C0G
Kemet | C0402C220G5GACTU | 22p | N | 0402 | Capacitor_SMD:C_0402_1005Metric | 0.5 | 2% | https://www.mouser.co.uk/datasheet/2/447/KEM_C1006_X5R_SMD-3316465.pdf | N | 50V | NP0/C0G
Kemet | C0402C111J5GACTU | 110p | N | 0402 | Capacitor_SMD:C_0402_1005Metric | 0.5 | 2% | https://www.mouser.co.uk/datasheet/2/447/KEM_C1006_X5R_SMD-3316465.pdf | N | 50V | NP0/C0G
Kemet | C0402C339B5GACTU | 3p3 | N | 0402 | Capacitor_SMD:C_0402_1005Metric | 0.5 | 0.1pF | https://www.mouser.co.uk/datasheet/2/447/KEM_C1006_X5R_SMD-3316465.pdf | N | 50V | NP0/C0G
Kemet | C0402C681J8GACTU | 680p | N | 0402 | Capacitor_SMD:C_0402_1005Metric | 0.5 | 2% | https://www.mouser.co.uk/datasheet/2/447/KEM_C1006_X5R_SMD-3316465.pdf | N | 10V | NP0/C0G
Kemet | C0402C309B5GACTU | 3p | N | 0402 | Capacitor_SMD:C_0402_1005Metric | 0.5 | 0.1pF | https://www.mouser.co.uk/datasheet/2/447/KEM_C1006_X5R_SMD-3316465.pdf | N | 50V | NP0/C0G
Kemet | C0402C431J5GACTU | 430p | N | 0402 | Capacitor_SMD:C_0402_1005Metric | 0.5 | 2% | https://www.mouser.co.uk/datasheet/2/447/KEM_C1006_X5R_SMD-3316465.pdf | N | 50V | NP0/C0G
Kemet | C0402C221G5GACTU | 220p | N | 0402 | Capacitor_SMD:C_0402_1005Metric | 0.5 | 2% | https://www.mouser.co.uk/datasheet/2/447/KEM_C1006_X5R_SMD-3316465.pdf | N | 50V | NP0/C0G
Kemet | C0402C471J1GACTU | 470p | N | 0402 | Capacitor_SMD:C_0402_1005Metric | 0.5 | 2% | https://www.mouser.co.uk/datasheet/2/447/KEM_C1006_X5R_SMD-3316465.pdf | N | 100V | NP0/C0G
Kemet | C0402C681G5GACTU | 680p | N | 0402 | Capacitor_SMD:C_0402_1005Metric | 0.5 | 2% | https://www.mouser.co.uk/datasheet/2/447/KEM_C1006_X5R_SMD-3316465.pdf | N | 50V | NP0/C0G
Kemet | C0402C621J5GACTU | 620p | N | 0402 | Capacitor_SMD:C_0402_1005Metric | 0.5 | 2% | https://www.mouser.co.uk/datasheet/2/447/KEM_C1006_X5R_SMD-3316465.pdf | N | 50V | NP0/C0G
Kemet | C0402C680G5GACTU | 68p | N | 0402 | Capacitor_SMD:C_0402_1005Metric | 0.5 | 2% | https://www.mouser.co.uk/datasheet/2/447/KEM_C1006_X5R_SMD-3316465.pdf | N | 50V | NP0/C0G
Kemet | C0402C122J5GACTU | 1n2 | N | 0402 | Capacitor_SMD:C_0402_1005Metric | 0.5 | 2% | https://www.mouser.co.uk/datasheet/2/447/KEM_C1006_X5R_SMD-3316465.pdf | N | 50V | NP0/C0G
Kemet | C0402C911J5GACTU | 910p | N | 0402 | Capacitor_SMD:C_0402_1005Metric | 0.5 | 2% | https://www.mouser.co.uk/datasheet/2/447/KEM_C1006_X5R_SMD-3316465.pdf | N | 50V | NP0/C0G
Kemet | C0402C510J5GACTU | 51p | N | 0402 | Capacitor_SMD:C_0402_1005Metric | 0.5 | 2% | https://www.mouser.co.uk/datasheet/2/447/KEM_C1006_X5R_SMD-3316465.pdf | N | 50V | NP0/C0G
Kemet | C0402C109B5GACTU | 1p | N | 0402 | Capacitor_SMD:C_0402_1005Metric | 0.5 | 0.1pF | https://www.mouser.co.uk/datasheet/2/447/KEM_C1006_X5R_SMD-3316465.pdf | N | 50V | NP0/C0G
Kemet | C0402C279C5GACTU | 2p7 | N | 0402 | Capacitor_SMD:C_0402_1005Metric | 0.5 | 0.25pF | https://www.mouser.co.uk/datasheet/2/447/KEM_C1006_X5R_SMD-3316465.pdf | N | 50V | NP0/C0G
Kemet | C0402C180J5GACTU | 18p | N | 0402 | Capacitor_SMD:C_0402_1005Metric | 0.5 | 2% | https://www.mouser.co.uk/datasheet/2/447/KEM_C1006_X5R_SMD-3316465.pdf | N | 50V | NP0/C0G
Kemet | C0402C109C5GACTU | 1p | N | 0402 | Capacitor_SMD:C_0402_1005Metric | 0.5 | 0.25pF | https://www.mouser.co.uk/datasheet/2/447/KEM_C1006_X5R_SMD-3316465.pdf | N | 50V | NP0/C0G
Kemet | C0402C224K9PACTU | 220n | N | 0402 | Capacitor_SMD:C_0402_1005Metric | 0.5 | 10% | https://www.mouser.co.uk/datasheet/2/447/KEM_C1006_X5R_SMD-3316465.pdf | N | 6.3V | X5R
Kemet | C0402C689C5GACTU | 6p8 | N | 0402 | Capacitor_SMD:C_0402_1005Metric | 0.5 | 0.25pF | https://www.mouser.co.uk/datasheet/2/447/KEM_C1006_X5R_SMD-3316465.pdf | N | 50V | NP0/C0G
Kemet | C0402C689D5GACTU | 6p8 | N | 0402 | Capacitor_SMD:C_0402_1005Metric | 0.5 | 0.5pF | https://www.mouser.co.uk/datasheet/2/447/KEM_C1006_X5R_SMD-3316465.pdf | N | 50V | NP0/C0G
Kemet | C0402C229C5GACTU | 2p2 | N | 0402 | Capacitor_SMD:C_0402_1005Metric | 0.5 | 0.25pF | https://www.mouser.co.uk/datasheet/2/447/KEM_C1006_X5R_SMD-3316465.pdf | N | 50V | NP0/C0G
Kemet | C0402C479D5GACTU | 4p7 | N | 0402 | Capacitor_SMD:C_0402_1005Metric | 0.5 | 0.5pF | https://www.mouser.co.uk/datasheet/2/447/KEM_C1006_X5R_SMD-3316465.pdf | N | 50V | NP0/C0G
Kemet | C0402C221J5GACTU | 220p | N | 0402 | Capacitor_SMD:C_0402_1005Metric | 0.5 | 2% | https://www.mouser.co.uk/datasheet/2/447/KEM_C1006_X5R_SMD-3316465.pdf | N | 50V | NP0/C0G
Kemet | C0402C399D5GACTU | 3p9 | N | 0402 | Capacitor_SMD:C_0402_1005Metric | 0.5 | 0.5pF | https://www.mouser.co.uk/datasheet/2/447/KEM_C1006_X5R_SMD-3316465.pdf | N | 50V | NP0/C0G
Kemet | C0402C110G5GACTU | 11p | N | 0402 | Capacitor_SMD:C_0402_1005Metric | 0.5 | 2% | https://www.mouser.co.uk/datasheet/2/447/KEM_C1006_X5R_SMD-3316465.pdf | N | 50V | NP0/C0G
Kemet | C0402C919C5GACTU | 9p1 | N | 0402 | Capacitor_SMD:C_0402_1005Metric | 0.5 | 0.25pF | https://www.mouser.co.uk/datasheet/2/447/KEM_C1006_X5R_SMD-3316465.pdf | N | 50V | NP0/C0G
Kemet | C0402C390K5GACTU | 39p | N | 0402 | Capacitor_SMD:C_0402_1005Metric | 0.5 | 10% | https://www.mouser.co.uk/datasheet/2/447/KEM_C1006_X5R_SMD-3316465.pdf | N | 50V | NP0/C0G
Kemet | C0402C330J8GACTU | 33p | N | 0402 | Capacitor_SMD:C_0402_1005Metric | 0.5 | 2% | https://www.mouser.co.uk/datasheet/2/447/KEM_C1006_X5R_SMD-3316465.pdf | N | 10V | NP0/C0G
Kemet | C0402C333K8PACTU | 33n | N | 0402 | Capacitor_SMD:C_0402_1005Metric | 0.5 | 10% | https://www.mouser.co.uk/datasheet/2/447/KEM_C1006_X5R_SMD-3316465.pdf | N | 10V | X5R
Kemet | C0402C129B5GACTU | 1p2 | N | 0402 | Capacitor_SMD:C_0402_1005Metric | 0.5 | 0.1pF | https://www.mouser.co.uk/datasheet/2/447/KEM_C1006_X5R_SMD-3316465.pdf | N | 50V | NP0/C0G
Kemet | C0402C300J5GACTU | 30p | N | 0402 | Capacitor_SMD:C_0402_1005Metric | 0.5 | 2% | https://www.mouser.co.uk/datasheet/2/447/KEM_C1006_X5R_SMD-3316465.pdf | N | 50V | NP0/C0G
Kemet | C0402C100J3GACTU | 10p | N | 0402 | Capacitor_SMD:C_0402_1005Metric | 0.5 | 2% | https://www.mouser.co.uk/datasheet/2/447/KEM_C1006_X5R_SMD-3316465.pdf | N | 25V | NP0/C0G
Kemet | C0402C473K4PACTU | 47n | N | 0402 | Capacitor_SMD:C_0402_1005Metric | 0.5 | 10% | https://www.mouser.co.uk/datasheet/2/447/KEM_C1006_X5R_SMD-3316465.pdf | N | 16V | X5R
Kemet | C0402C223K8PACTU | 22n | N | 0402 | Capacitor_SMD:C_0402_1005Metric | 0.5 | 10% | https://www.mouser.co.uk/datasheet/2/447/KEM_C1006_X5R_SMD-3316465.pdf | N | 10V | X5R
Kemet | C0402C150G5GACTU | 15p | N | 0402 | Capacitor_SMD:C_0402_1005Metric | 0.5 | 2% | https://www.mouser.co.uk/datasheet/2/447/KEM_C1006_X5R_SMD-3316465.pdf | N | 50V | NP0/C0G
Kemet | C0402C360G5GACTU | 36p | N | 0402 | Capacitor_SMD:C_0402_1005Metric | 0.5 | 2% | https://www.mouser.co.uk/datasheet/2/447/KEM_C1006_X5R_SMD-3316465.pdf | N | 50V | NP0/C0G
Kemet | C0402C339C5GACTU | 3p3 | N | 0402 | Capacitor_SMD:C_0402_1005Metric | 0.5 | 0.25pF | https://www.mouser.co.uk/datasheet/2/447/KEM_C1006_X5R_SMD-3316465.pdf | N | 50V | NP0/C0G
Kemet | C0402C150J8GACTU | 15p | N | 0402 | Capacitor_SMD:C_0402_1005Metric | 0.5 | 2% | https://www.mouser.co.uk/datasheet/2/447/KEM_C1006_X5R_SMD-3316465.pdf | N | 10V | NP0/C0G
Kemet | C0402C100F5GACTU | 10p | N | 0402 | Capacitor_SMD:C_0402_1005Metric | 0.5 | 1% | https://www.mouser.co.uk/datasheet/2/447/KEM_C1006_X5R_SMD-3316465.pdf | N | 50V | NP0/C0G
Kemet | C0402C102G3GACTU | 1n | N | 0402 | Capacitor_SMD:C_0402_1005Metric | 0.5 | 2% | https://www.mouser.co.uk/datasheet/2/447/KEM_C1006_X5R_SMD-3316465.pdf | N | 25V | NP0/C0G
Kemet | C0402C100D5GACTU | 10p | N | 0402 | Capacitor_SMD:C_0402_1005Metric | 0.5 | 0.5pF | https://www.mouser.co.uk/datasheet/2/447/KEM_C1006_X5R_SMD-3316465.pdf | N | 50V | NP0/C0G
Kemet | C0402C910F3GACTU | 91p | N | 0402 | Capacitor_SMD:C_0402_1005Metric | 0.5 | 1% | https://www.mouser.co.uk/datasheet/2/447/KEM_C1006_X5R_SMD-3316465.pdf | N | 25V | NP0/C0G
Kemet | C0402C360F5GACTU | 36p | N | 0402 | Capacitor_SMD:C_0402_1005Metric | 0.5 | 1% | https://www.mouser.co.uk/datasheet/2/447/KEM_C1006_X5R_SMD-3316465.pdf | N | 50V | NP0/C0G
Kemet | C0402C333K9PACTU | 33n | N | 0402 | Capacitor_SMD:C_0402_1005Metric | 0.5 | 10% | https://www.mouser.co.uk/datasheet/2/447/KEM_C1006_X5R_SMD-3316465.pdf | N | 6.3V | X5R
Kemet | C0402C104M3PACTU | 100n | N | 0402 | Capacitor_SMD:C_0402_1005Metric | 0.5 | 20% | https://www.mouser.co.uk/datasheet/2/447/KEM_C1006_X5R_SMD-3316465.pdf | N | 25V | X5R
Kemet | C0402C823K8PACTU | 82n | N | 0402 | Capacitor_SMD:C_0402_1005Metric | 0.5 | 10% | https://www.mouser.co.uk/datasheet/2/447/KEM_C1006_X5R_SMD-3316465.pdf | N | 10V | X5R
Kemet | C0402C200K5GACTU | 20p | N | 0402 | Capacitor_SMD:C_0402_1005Metric | 0.5 | 10% | https://www.mouser.co.uk/datasheet/2/447/KEM_C1006_X5R_SMD-3316465.pdf | N | 50V | NP0/C0G
Kemet | C0402C123K8PACTU | 12n | N | 0402 | Capacitor_SMD:C_0402_1005Metric | 0.5 | 10% | https://www.mouser.co.uk/datasheet/2/447/KEM_C1006_X5R_SMD-3316465.pdf | N | 10V | X5R
Kemet | C0402C223K9PACTU | 22n | N | 0402 | Capacitor_SMD:C_0402_1005Metric | 0.5 | 10% | https://www.mouser.co.uk/datasheet/2/447/KEM_C1006_X5R_SMD-3316465.pdf | N | 6.3V | X5R
Kemet | C0402C160J5GACTU | 16p | N | 0402 | Capacitor_SMD:C_0402_1005Metric | 0.5 | 2% | https://www.mouser.co.uk/datasheet/2/447/KEM_C1006_X5R_SMD-3316465.pdf | N | 50V | NP0/C0G
Kemet | C0402C102K3GACTU | 1n | N | 0402 | Capacitor_SMD:C_0402_1005Metric | 0.5 | 10% | https://www.mouser.co.uk/datasheet/2/447/KEM_C1006_X5R_SMD-3316465.pdf | N | 25V | NP0/C0G
Kemet | C0402C474K7PACTU | 470n | N | 0402 | Capacitor_SMD:C_0402_1005Metric | 0.5 | 10% | https://www.mouser.co.uk/datasheet/2/447/KEM_C1006_X5R_SMD-3316465.pdf | N | 4V | X5R
Kemet | C0402C473K9PACTU | 47n | N | 0402 | Capacitor_SMD:C_0402_1005Metric | 0.5 | 10% | https://www.mouser.co.uk/datasheet/2/447/KEM_C1006_X5R_SMD-3316465.pdf | N | 6.3V | X5R
Kemet | C0402C300K5GACTU | 30p | N | 0402 | Capacitor_SMD:C_0402_1005Metric | 0.5 | 10% | https://www.mouser.co.uk/datasheet/2/447/KEM_C1006_X5R_SMD-3316465.pdf | N | 50V | NP0/C0G
Kemet | C0402C153K9PACTU | 15n | N | 0402 | Capacitor_SMD:C_0402_1005Metric | 0.5 | 10% | https://www.mouser.co.uk/datasheet/2/447/KEM_C1006_X5R_SMD-3316465.pdf | N | 6.3V | X5R
Kemet | C0402C335M7PACTU | 3u3 | N | 0402 | Capacitor_SMD:C_0402_1005Metric | 0.5 | 20% | https://www.mouser.co.uk/datasheet/2/447/KEM_C1006_X5R_SMD-3316465.pdf | N | 4V | X5R
Kemet | C0402C220J5GACTU | 22p | N | 0402 | Capacitor_SMD:C_0402_1005Metric | 0.5 | 2% | https://www.mouser.co.uk/datasheet/2/447/KEM_C1006_X5R_SMD-3316465.pdf | N | 50V | NP0/C0G
Kemet | C0402C121J5GACTU | 120p | N | 0402 | Capacitor_SMD:C_0402_1005Metric | 0.5 | 2% | https://www.mouser.co.uk/datasheet/2/447/KEM_C1006_X5R_SMD-3316465.pdf | N | 50V | NP0/C0G
Kemet | C0402C150J4GACTU | 15p | N | 0402 | Capacitor_SMD:C_0402_1005Metric | 0.5 | 2% | https://www.mouser.co.uk/datasheet/2/447/KEM_C1006_X5R_SMD-3316465.pdf | N | 16V | NP0/C0G
Kemet | C0402C681J5GACTU | 680p | N | 0402 | Capacitor_SMD:C_0402_1005Metric | 0.5 | 2% | https://www.mouser.co.uk/datasheet/2/447/KEM_C1006_X5R_SMD-3316465.pdf | N | 50V | NP0/C0G
Kemet | C0402C105M4PACTU | 1u | N | 0402 | Capacitor_SMD:C_0402_1005Metric | 0.5 | 20% | https://www.mouser.co.uk/datasheet/2/447/KEM_C1006_X5R_SMD-3316465.pdf | N | 16V | X5R
Kemet | C0402C221K5GACTU | 220p | N | 0402 | Capacitor_SMD:C_0402_1005Metric | 0.5 | 10% | https://www.mouser.co.uk/datasheet/2/447/KEM_C1006_X5R_SMD-3316465.pdf | N | 50V | NP0/C0G
Kemet | C0402C180J4GACTU | 18p | N | 0402 | Capacitor_SMD:C_0402_1005Metric | 0.5 | 2% | https://www.mouser.co.uk/datasheet/2/447/KEM_C1006_X5R_SMD-3316465.pdf | N | 16V | NP0/C0G
Kemet | C0402C101K5GACTU | 100p | N | 0402 | Capacitor_SMD:C_0402_1005Metric | 0.5 | 10% | https://www.mouser.co.uk/datasheet/2/447/KEM_C1006_X5R_SMD-3316465.pdf | N | 50V | NP0/C0G
Kemet | C0402C220K5GACTU | 22p | N | 0402 | Capacitor_SMD:C_0402_1005Metric | 0.5 | 10% | https://www.mouser.co.uk/datasheet/2/447/KEM_C1006_X5R_SMD-3316465.pdf | N | 50V | NP0/C0G
Kemet | C0402C102J3GACTU | 1n | N | 0402 | Capacitor_SMD:C_0402_1005Metric | 0.5 | 2% | https://www.mouser.co.uk/datasheet/2/447/KEM_C1006_X5R_SMD-3316465.pdf | N | 25V | NP0/C0G
Kemet | C0402C130J5GACTU | 13p | N | 0402 | Capacitor_SMD:C_0402_1005Metric | 0.5 | 2% | https://www.mouser.co.uk/datasheet/2/447/KEM_C1006_X5R_SMD-3316465.pdf | N | 50V | NP0/C0G
Kemet | C0402C470J5GACTU | 47p | N | 0402 | Capacitor_SMD:C_0402_1005Metric | 0.5 | 2% | https://www.mouser.co.uk/datasheet/2/447/KEM_C1006_X5R_SMD-3316465.pdf | N | 50V | NP0/C0G
Kemet | C0402C399C5GACTU | 3p9 | N | 0402 | Capacitor_SMD:C_0402_1005Metric | 0.5 | 0.25pF | https://www.mouser.co.uk/datasheet/2/447/KEM_C1006_X5R_SMD-3316465.pdf | N | 50V | NP0/C0G
Kemet | C0402C560J5GACTU | 56p | N | 0402 | Capacitor_SMD:C_0402_1005Metric | 0.5 | 2% | https://www.mouser.co.uk/datasheet/2/447/KEM_C1006_X5R_SMD-3316465.pdf | N | 50V | NP0/C0G
Kemet | C0402C181K5GACTU | 180p | N | 0402 | Capacitor_SMD:C_0402_1005Metric | 0.5 | 10% | https://www.mouser.co.uk/datasheet/2/447/KEM_C1006_X5R_SMD-3316465.pdf | N | 50V | NP0/C0G
Kemet | C0402C629C5GACTU | 6p2 | N | 0402 | Capacitor_SMD:C_0402_1005Metric | 0.5 | 0.25pF | https://www.mouser.co.uk/datasheet/2/447/KEM_C1006_X5R_SMD-3316465.pdf | N | 50V | NP0/C0G
Kemet | C0402C361J5GACTU | 360p | N | 0402 | Capacitor_SMD:C_0402_1005Metric | 0.5 | 2% | https://www.mouser.co.uk/datasheet/2/447/KEM_C1006_X5R_SMD-3316465.pdf | N | 50V | NP0/C0G
Kemet | C0402C150J3GACTU | 15p | N | 0402 | Capacitor_SMD:C_0402_1005Metric | 0.5 | 2% | https://www.mouser.co.uk/datasheet/2/447/KEM_C1006_X5R_SMD-3316465.pdf | N | 25V | NP0/C0G
Kemet | C0402C471K3GACTU | 470p | N | 0402 | Capacitor_SMD:C_0402_1005Metric | 0.5 | 10% | https://www.mouser.co.uk/datasheet/2/447/KEM_C1006_X5R_SMD-3316465.pdf | N | 25V | NP0/C0G
Kemet | C0402C120J3GACTU | 12p | N | 0402 | Capacitor_SMD:C_0402_1005Metric | 0.5 | 2% | https://www.mouser.co.uk/datasheet/2/447/KEM_C1006_X5R_SMD-3316465.pdf | N | 25V | NP0/C0G
Kemet | C0402C569D5GACTU | 5p6 | N | 0402 | Capacitor_SMD:C_0402_1005Metric | 0.5 | 0.5pF | https://www.mouser.co.uk/datasheet/2/447/KEM_C1006_X5R_SMD-3316465.pdf | N | 50V | NP0/C0G
Kemet | C0402C750J5GACTU | 75p | N | 0402 | Capacitor_SMD:C_0402_1005Metric | 0.5 | 2% | https://www.mouser.co.uk/datasheet/2/447/KEM_C1006_X5R_SMD-3316465.pdf | N | 50V | NP0/C0G
Kemet | C0402C330K4GACTU | 33p | N | 0402 | Capacitor_SMD:C_0402_1005Metric | 0.5 | 10% | https://www.mouser.co.uk/datasheet/2/447/KEM_C1006_X5R_SMD-3316465.pdf | N | 16V | NP0/C0G
Kemet | C0402C471K5GACTU | 470p | N | 0402 | Capacitor_SMD:C_0402_1005Metric | 0.5 | 10% | https://www.mouser.co.uk/datasheet/2/447/KEM_C1006_X5R_SMD-3316465.pdf | N | 50V | NP0/C0G
Kemet | C0402C360J5GACTU | 36p | N | 0402 | Capacitor_SMD:C_0402_1005Metric | 0.5 | 2% | https://www.mouser.co.uk/datasheet/2/447/KEM_C1006_X5R_SMD-3316465.pdf | N | 50V | NP0/C0G
Kemet | C0402C103K4PACTU | 10n | N | 0402 | Capacitor_SMD:C_0402_1005Metric | 0.5 | 10% | https://www.mouser.co.uk/datasheet/2/447/KEM_C1006_X5R_SMD-3316465.pdf | N | 16V | X5R
Kemet | C0402C475M7PACTU | 4u7 | N | 0402 | Capacitor_SMD:C_0402_1005Metric | 0.5 | 20% | https://www.mouser.co.uk/datasheet/2/447/KEM_C1006_X5R_SMD-3316465.pdf | N | 4V | X5R
Kemet | C0402C331J5GACTU | 330p | N | 0402 | Capacitor_SMD:C_0402_1005Metric | 0.5 | 2% | https://www.mouser.co.uk/datasheet/2/447/KEM_C1006_X5R_SMD-3316465.pdf | N | 50V | NP0/C0G
Kemet | C0402C151J5GACTU | 150p | N | 0402 | Capacitor_SMD:C_0402_1005Metric | 0.5 | 2% | https://www.mouser.co.uk/datasheet/2/447/KEM_C1006_X5R_SMD-3316465.pdf | N | 50V | NP0/C0G
Kemet | C0402C270J3GACTU | 27p | N | 0402 | Capacitor_SMD:C_0402_1005Metric | 0.5 | 2% | https://www.mouser.co.uk/datasheet/2/447/KEM_C1006_X5R_SMD-3316465.pdf | N | 25V | NP0/C0G
Kemet | C0402C189C5GACTU | 1p8 | N | 0402 | Capacitor_SMD:C_0402_1005Metric | 0.5 | 0.25pF | https://www.mouser.co.uk/datasheet/2/447/KEM_C1006_X5R_SMD-3316465.pdf | N | 50V | NP0/C0G
Kemet | C0402C270K5GACTU | 27p | N | 0402 | Capacitor_SMD:C_0402_1005Metric | 0.5 | 10% | https://www.mouser.co.uk/datasheet/2/447/KEM_C1006_X5R_SMD-3316465.pdf | N | 50V | NP0/C0G
Kemet | C0402C159C5GACTU | 1p5 | N | 0402 | Capacitor_SMD:C_0402_1005Metric | 0.5 | 0.25pF | https://www.mouser.co.uk/datasheet/2/447/KEM_C1006_X5R_SMD-3316465.pdf | N | 50V | NP0/C0G
Kemet | C0402C508C5GACTU | 0p5 | N | 0402 | Capacitor_SMD:C_0402_1005Metric | 0.5 | 0.25pF | https://www.mouser.co.uk/datasheet/2/447/KEM_C1006_X5R_SMD-3316465.pdf | N | 50V | NP0/C0G
Kemet | C0402C162J3GACTU | 1n6 | N | 0402 | Capacitor_SMD:C_0402_1005Metric | 0.5 | 2% | https://www.mouser.co.uk/datasheet/2/447/KEM_C1006_X5R_SMD-3316465.pdf | N | 25V | NP0/C0G
Kemet | C0402C101J3GACTU | 100p | N | 0402 | Capacitor_SMD:C_0402_1005Metric | 0.5 | 2% | https://www.mouser.co.uk/datasheet/2/447/KEM_C1006_X5R_SMD-3316465.pdf | N | 25V | NP0/C0G
Kemet | C0402C569C5GACTU | 5p6 | N | 0402 | Capacitor_SMD:C_0402_1005Metric | 0.5 | 0.25pF | https://www.mouser.co.uk/datasheet/2/447/KEM_C1006_X5R_SMD-3316465.pdf | N | 50V | NP0/C0G
Kemet | C0402C120J8GACTU | 12p | N | 0402 | Capacitor_SMD:C_0402_1005Metric | 0.5 | 2% | https://www.mouser.co.uk/datasheet/2/447/KEM_C1006_X5R_SMD-3316465.pdf | N | 10V | NP0/C0G
Kemet | C0402C151J1GACTU | 150p | N | 0402 | Capacitor_SMD:C_0402_1005Metric | 0.5 | 2% | https://www.mouser.co.uk/datasheet/2/447/KEM_C1006_X5R_SMD-3316465.pdf | N | 100V | NP0/C0G
Kemet | C0402C249C5GACTU | 2p4 | N | 0402 | Capacitor_SMD:C_0402_1005Metric | 0.5 | 0.25pF | https://www.mouser.co.uk/datasheet/2/447/KEM_C1006_X5R_SMD-3316465.pdf | N | 50V | NP0/C0G
Kemet | C0402C273K9PACTU | 27n | N | 0402 | Capacitor_SMD:C_0402_1005Metric | 0.5 | 10% | https://www.mouser.co.uk/datasheet/2/447/KEM_C1006_X5R_SMD-3316465.pdf | N | 6.3V | X5R
Kemet | C0402C309C5GACTU | 3p | N | 0402 | Capacitor_SMD:C_0402_1005Metric | 0.5 | 0.25pF | https://www.mouser.co.uk/datasheet/2/447/KEM_C1006_X5R_SMD-3316465.pdf | N | 50V | NP0/C0G
Kemet | C0402C919D5GACTU | 9p1 | N | 0402 | Capacitor_SMD:C_0402_1005Metric | 0.5 | 0.5pF | https://www.mouser.co.uk/datasheet/2/447/KEM_C1006_X5R_SMD-3316465.pdf | N | 50V | NP0/C0G
Kemet | C0402C189D3GACTU | 1p8 | N | 0402 | Capacitor_SMD:C_0402_1005Metric | 0.5 | 0.5pF | https://www.mouser.co.uk/datasheet/2/447/KEM_C1006_X5R_SMD-3316465.pdf | N | 25V | NP0/C0G
Kemet | C0402C271J5GACTU | 270p | N | 0402 | Capacitor_SMD:C_0402_1005Metric | 0.5 | 2% | https://www.mouser.co.uk/datasheet/2/447/KEM_C1006_X5R_SMD-3316465.pdf | N | 50V | NP0/C0G
Kemet | C0402C101J4GACTU | 100p | N | 0402 | Capacitor_SMD:C_0402_1005Metric | 0.5 | 2% | https://www.mouser.co.uk/datasheet/2/447/KEM_C1006_X5R_SMD-3316465.pdf | N | 16V | NP0/C0G
Kemet | C0402C221J3GACTU | 220p | N | 0402 | Capacitor_SMD:C_0402_1005Metric | 0.5 | 2% | https://www.mouser.co.uk/datasheet/2/447/KEM_C1006_X5R_SMD-3316465.pdf | N | 25V | NP0/C0G
Kemet | C0402C333K4PACTU | 33n | N | 0402 | Capacitor_SMD:C_0402_1005Metric | 0.5 | 10% | https://www.mouser.co.uk/datasheet/2/447/KEM_C1006_X5R_SMD-3316465.pdf | N | 16V | X5R
Kemet | C0402C273K4PACTU | 27n | N | 0402 | Capacitor_SMD:C_0402_1005Metric | 0.5 | 10% | https://www.mouser.co.uk/datasheet/2/447/KEM_C1006_X5R_SMD-3316465.pdf | N | 16V | X5R
Kemet | C0402C151JAGACTU | 150p | N | 0402 | Capacitor_SMD:C_0402_1005Metric | 0.5 | 2% | https://www.mouser.co.uk/datasheet/2/447/KEM_C1006_X5R_SMD-3316465.pdf | N | 250V | NP0/C0G
Kemet | C0402C820K3GACTU | 82p | N | 0402 | Capacitor_SMD:C_0402_1005Metric | 0.5 | 10% | https://www.mouser.co.uk/datasheet/2/447/KEM_C1006_X5R_SMD-3316465.pdf | N | 25V | NP0/C0G
Kemet | C0402C271K5GACTU | 270p | N | 0402 | Capacitor_SMD:C_0402_1005Metric | 0.5 | 10% | https://www.mouser.co.uk/datasheet/2/447/KEM_C1006_X5R_SMD-3316465.pdf | N | 50V | NP0/C0G
Kemet | C0402C220J4GACTU | 22p | N | 0402 | Capacitor_SMD:C_0402_1005Metric | 0.5 | 2% | https://www.mouser.co.uk/datasheet/2/447/KEM_C1006_X5R_SMD-3316465.pdf | N | 16V | NP0/C0G
Kemet | C0402C331J1GACTU | 330p | N | 0402 | Capacitor_SMD:C_0402_1005Metric | 0.5 | 2% | https://www.mouser.co.uk/datasheet/2/447/KEM_C1006_X5R_SMD-3316465.pdf | N | 100V | NP0/C0G
Kemet | C0402C470J4GACTU | 47p | N | 0402 | Capacitor_SMD:C_0402_1005Metric | 0.5 | 2% | https://www.mouser.co.uk/datasheet/2/447/KEM_C1006_X5R_SMD-3316465.pdf | N | 16V | NP0/C0G
Kemet | C0402C100K4GACTU | 10p | N | 0402 | Capacitor_SMD:C_0402_1005Metric | 0.5 | 10% | https://www.mouser.co.uk/datasheet/2/447/KEM_C1006_X5R_SMD-3316465.pdf | N | 16V | NP0/C0G
Kemet | C0402C479C3GACTU | 4p7 | N | 0402 | Capacitor_SMD:C_0402_1005Metric | 0.5 | 0.25pF | https://www.mouser.co.uk/datasheet/2/447/KEM_C1006_X5R_SMD-3316465.pdf | N | 25V | NP0/C0G
Kemet | C0402C270J4GACTU | 27p | N | 0402 | Capacitor_SMD:C_0402_1005Metric | 0.5 | 2% | https://www.mouser.co.uk/datasheet/2/447/KEM_C1006_X5R_SMD-3316465.pdf | N | 16V | NP0/C0G
Kemet | C0402C479K5GACTU | 4p7 | N | 0402 | Capacitor_SMD:C_0402_1005Metric | 0.5 | 10% | https://www.mouser.co.uk/datasheet/2/447/KEM_C1006_X5R_SMD-3316465.pdf | N | 50V | NP0/C0G
Kemet | C0402C330J3GACTU | 33p | N | 0402 | Capacitor_SMD:C_0402_1005Metric | 0.5 | 2% | https://www.mouser.co.uk/datasheet/2/447/KEM_C1006_X5R_SMD-3316465.pdf | N | 25V | NP0/C0G
Kemet | C0402C620J5GACTU | 62p | N | 0402 | Capacitor_SMD:C_0402_1005Metric | 0.5 | 2% | https://www.mouser.co.uk/datasheet/2/447/KEM_C1006_X5R_SMD-3316465.pdf | N | 50V | NP0/C0G
Kemet | C0402C181J5GACTU | 180p | N | 0402 | Capacitor_SMD:C_0402_1005Metric | 0.5 | 2% | https://www.mouser.co.uk/datasheet/2/447/KEM_C1006_X5R_SMD-3316465.pdf | N | 50V | NP0/C0G
Kemet | C0402C100K5GACTU | 10p | N | 0402 | Capacitor_SMD:C_0402_1005Metric | 0.5 | 10% | https://www.mouser.co.uk/datasheet/2/447/KEM_C1006_X5R_SMD-3316465.pdf | N | 50V | NP0/C0G
Kemet | C0402C390J5GACTU | 39p | N | 0402 | Capacitor_SMD:C_0402_1005Metric | 0.5 | 2% | https://www.mouser.co.uk/datasheet/2/447/KEM_C1006_X5R_SMD-3316465.pdf | N | 50V | NP0/C0G
Kemet | C0402C101K1GACTU | 100p | N | 0402 | Capacitor_SMD:C_0402_1005Metric | 0.5 | 10% | https://www.mouser.co.uk/datasheet/2/447/KEM_C1006_X5R_SMD-3316465.pdf | N | 100V | NP0/C0G
Kemet | C0402C560J3GACTU | 56p | N | 0402 | Capacitor_SMD:C_0402_1005Metric | 0.5 | 2% | https://www.mouser.co.uk/datasheet/2/447/KEM_C1006_X5R_SMD-3316465.pdf | N | 25V | NP0/C0G
Kemet | C0402C680J5GACTU | 68p | N | 0402 | Capacitor_SMD:C_0402_1005Metric | 0.5 | 2% | https://www.mouser.co.uk/datasheet/2/447/KEM_C1006_X5R_SMD-3316465.pdf | N | 50V | NP0/C0G
Kemet | C0402C151K5GACTU | 150p | N | 0402 | Capacitor_SMD:C_0402_1005Metric | 0.5 | 10% | https://www.mouser.co.uk/datasheet/2/447/KEM_C1006_X5R_SMD-3316465.pdf | N | 50V | NP0/C0G
Kemet | C0402C470K4GACTU | 47p | N | 0402 | Capacitor_SMD:C_0402_1005Metric | 0.5 | 10% | https://www.mouser.co.uk/datasheet/2/447/KEM_C1006_X5R_SMD-3316465.pdf | N | 16V | NP0/C0G
Kemet | C0402C220K8GACTU | 22p | N | 0402 | Capacitor_SMD:C_0402_1005Metric | 0.5 | 10% | https://www.mouser.co.uk/datasheet/2/447/KEM_C1006_X5R_SMD-3316465.pdf | N | 10V | NP0/C0G
Kemet | C0402C209C5GACTU | 2p | N | 0402 | Capacitor_SMD:C_0402_1005Metric | 0.5 | 0.25pF | https://www.mouser.co.uk/datasheet/2/447/KEM_C1006_X5R_SMD-3316465.pdf | N | 50V | NP0/C0G
Kemet | C0402C479C4GACTU | 4p7 | N | 0402 | Capacitor_SMD:C_0402_1005Metric | 0.5 | 0.25pF | https://www.mouser.co.uk/datasheet/2/447/KEM_C1006_X5R_SMD-3316465.pdf | N | 16V | NP0/C0G
Kemet | C0402C751G5GACTU | 750p | N | 0402 | Capacitor_SMD:C_0402_1005Metric | 0.5 | 2% | https://www.mouser.co.uk/datasheet/2/447/KEM_C1006_X5R_SMD-3316465.pdf | N | 50V | NP0/C0G
Kemet | C0402C221K3GACTU | 220p | N | 0402 | Capacitor_SMD:C_0402_1005Metric | 0.5 | 10% | https://www.mouser.co.uk/datasheet/2/447/KEM_C1006_X5R_SMD-3316465.pdf | N | 25V | NP0/C0G
Kemet | C0402C104M9PACTU | 100n | N | 0402 | Capacitor_SMD:C_0402_1005Metric | 0.5 | 20% | https://www.mouser.co.uk/datasheet/2/447/KEM_C1006_X5R_SMD-3316465.pdf | N | 6.3V | X5R
Kemet | C0402C241J5GACTU | 240p | N | 0402 | Capacitor_SMD:C_0402_1005Metric | 0.5 | 2% | https://www.mouser.co.uk/datasheet/2/447/KEM_C1006_X5R_SMD-3316465.pdf | N | 50V | NP0/C0G
Kemet | C0402C300J3GACTU | 30p | N | 0402 | Capacitor_SMD:C_0402_1005Metric | 0.5 | 2% | https://www.mouser.co.uk/datasheet/2/447/KEM_C1006_X5R_SMD-3316465.pdf | N | 25V | NP0/C0G
Kemet | C0402C220J8GACTU | 22p | N | 0402 | Capacitor_SMD:C_0402_1005Metric | 0.5 | 2% | https://www.mouser.co.uk/datasheet/2/447/KEM_C1006_X5R_SMD-3316465.pdf | N | 10V | NP0/C0G
Kemet | C0402C829D5GACTU | 8p2 | N | 0402 | Capacitor_SMD:C_0402_1005Metric | 0.5 | 0.5pF | https://www.mouser.co.uk/datasheet/2/447/KEM_C1006_X5R_SMD-3316465.pdf | N | 50V | NP0/C0G
Kemet | C0402C151J3GACTU | 150p | N | 0402 | Capacitor_SMD:C_0402_1005Metric | 0.5 | 2% | https://www.mouser.co.uk/datasheet/2/447/KEM_C1006_X5R_SMD-3316465.pdf | N | 25V | NP0/C0G
Kemet | C0402C240J5GACTU | 24p | N | 0402 | Capacitor_SMD:C_0402_1005Metric | 0.5 | 2% | https://www.mouser.co.uk/datasheet/2/447/KEM_C1006_X5R_SMD-3316465.pdf | N | 50V | NP0/C0G
Kemet | C0402C104M8PACTU | 100n | N | 0402 | Capacitor_SMD:C_0402_1005Metric | 0.5 | 20% | https://www.mouser.co.uk/datasheet/2/447/KEM_C1006_X5R_SMD-3316465.pdf | N | 10V | X5R
Kemet | C0402C330K8GACTU | 33p | N | 0402 | Capacitor_SMD:C_0402_1005Metric | 0.5 | 10% | https://www.mouser.co.uk/datasheet/2/447/KEM_C1006_X5R_SMD-3316465.pdf | N | 10V | NP0/C0G
Kemet | C0402C561J3GACTU | 560p | N | 0402 | Capacitor_SMD:C_0402_1005Metric | 0.5 | 2% | https://www.mouser.co.uk/datasheet/2/447/KEM_C1006_X5R_SMD-3316465.pdf | N | 25V | NP0/C0G
Kemet | C0402C829C5GACTU | 8p2 | N | 0402 | Capacitor_SMD:C_0402_1005Metric | 0.5 | 0.25pF | https://www.mouser.co.uk/datasheet/2/447/KEM_C1006_X5R_SMD-3316465.pdf | N | 50V | NP0/C0G
Kemet | C0402C270F5GACTU | 27p | N | 0402 | Capacitor_SMD:C_0402_1005Metric | 0.5 | 1% | https://www.mouser.co.uk/datasheet/2/447/KEM_C1006_X5R_SMD-3316465.pdf | N | 50V | NP0/C0G
Kemet | C0402C180J3GACTU | 18p | N | 0402 | Capacitor_SMD:C_0402_1005Metric | 0.5 | 2% | https://www.mouser.co.uk/datasheet/2/447/KEM_C1006_X5R_SMD-3316465.pdf | N | 25V | NP0/C0G
Kemet | C0402C129C5GACTU | 1p2 | N | 0402 | Capacitor_SMD:C_0402_1005Metric | 0.5 | 0.25pF | https://www.mouser.co.uk/datasheet/2/447/KEM_C1006_X5R_SMD-3316465.pdf | N | 50V | NP0/C0G
Kemet | C0402C471J3GACTU | 470p | N | 0402 | Capacitor_SMD:C_0402_1005Metric | 0.5 | 2% | https://www.mouser.co.uk/datasheet/2/447/KEM_C1006_X5R_SMD-3316465.pdf | N | 25V | NP0/C0G
Kemet | C0402C821K5GACTU | 820p | N | 0402 | Capacitor_SMD:C_0402_1005Metric | 0.5 | 10% | https://www.mouser.co.uk/datasheet/2/447/KEM_C1006_X5R_SMD-3316465.pdf | N | 50V | NP0/C0G
Kemet | C0402C120J5GACTU | 12p | N | 0402 | Capacitor_SMD:C_0402_1005Metric | 0.5 | 2% | https://www.mouser.co.uk/datasheet/2/447/KEM_C1006_X5R_SMD-3316465.pdf | N | 50V | NP0/C0G
Kemet | C0402C220J3GACTU | 22p | N | 0402 | Capacitor_SMD:C_0402_1005Metric | 0.5 | 2% | https://www.mouser.co.uk/datasheet/2/447/KEM_C1006_X5R_SMD-3316465.pdf | N | 25V | NP0/C0G
Kemet | C0402C821J5GACTU | 820p | N | 0402 | Capacitor_SMD:C_0402_1005Metric | 0.5 | 2% | https://www.mouser.co.uk/datasheet/2/447/KEM_C1006_X5R_SMD-3316465.pdf | N | 50V | NP0/C0G
Kemet | C0402C104K9PACTU | 100n | N | 0402 | Capacitor_SMD:C_0402_1005Metric | 0.5 | 10% | https://www.mouser.co.uk/datasheet/2/447/KEM_C1006_X5R_SMD-3316465.pdf | N | 6.3V | X5R
Kemet | C0402C200G5GACTU | 20p | N | 0402 | Capacitor_SMD:C_0402_1005Metric | 0.5 | 2% | https://www.mouser.co.uk/datasheet/2/447/KEM_C1006_X5R_SMD-3316465.pdf | N | 50V | NP0/C0G
Kemet | C0402C820K5GACTU | 82p | N | 0402 | Capacitor_SMD:C_0402_1005Metric | 0.5 | 10% | https://www.mouser.co.uk/datasheet/2/447/KEM_C1006_X5R_SMD-3316465.pdf | N | 50V | NP0/C0G
Kemet | C0402C330K5GACTU | 33p | N | 0402 | Capacitor_SMD:C_0402_1005Metric | 0.5 | 10% | https://www.mouser.co.uk/datasheet/2/447/KEM_C1006_X5R_SMD-3316465.pdf | N | 50V | NP0/C0G
Kemet | C0402C331K5GACTU | 330p | N | 0402 | Capacitor_SMD:C_0402_1005Metric | 0.5 | 10% | https://www.mouser.co.uk/datasheet/2/447/KEM_C1006_X5R_SMD-3316465.pdf | N | 50V | NP0/C0G
Kemet | C0402C821J3GACTU | 820p | N | 0402 | Capacitor_SMD:C_0402_1005Metric | 0.5 | 2% | https://www.mouser.co.uk/datasheet/2/447/KEM_C1006_X5R_SMD-3316465.pdf | N | 25V | NP0/C0G
Kemet | C0402C683K8PACTU | 68n | N | 0402 | Capacitor_SMD:C_0402_1005Metric | 0.5 | 10% | https://www.mouser.co.uk/datasheet/2/447/KEM_C1006_X5R_SMD-3316465.pdf | N | 10V | X5R
Kemet | C0402C180K3GACTU | 18p | N | 0402 | Capacitor_SMD:C_0402_1005Metric | 0.5 | 10% | https://www.mouser.co.uk/datasheet/2/447/KEM_C1006_X5R_SMD-3316465.pdf | N | 25V | NP0/C0G
Kemet | C0402C150K5GACTU | 15p | N | 0402 | Capacitor_SMD:C_0402_1005Metric | 0.5 | 10% | https://www.mouser.co.uk/datasheet/2/447/KEM_C1006_X5R_SMD-3316465.pdf | N | 50V | NP0/C0G
Kemet | C0402C120D5GACTU | 12p | N | 0402 | Capacitor_SMD:C_0402_1005Metric | 0.5 | 0.5pF | https://www.mouser.co.uk/datasheet/2/447/KEM_C1006_X5R_SMD-3316465.pdf | N | 50V | NP0/C0G
Kemet | C0402C120C5GACTU | 12p | N | 0402 | Capacitor_SMD:C_0402_1005Metric | 0.5 | 0.25pF | https://www.mouser.co.uk/datasheet/2/447/KEM_C1006_X5R_SMD-3316465.pdf | N | 50V | NP0/C0G
Kemet | C0402C331JAGACTU | 330p | N | 0402 | Capacitor_SMD:C_0402_1005Metric | 0.5 | 2% | https://www.mouser.co.uk/datasheet/2/447/KEM_C1006_X5R_SMD-3316465.pdf | N | 250V | NP0/C0G
Kemet | C0402C105M9PACTU | 1u | N | 0402 | Capacitor_SMD:C_0402_1005Metric | 0.5 | 20% | https://www.mouser.co.uk/datasheet/2/447/KEM_C1006_X5R_SMD-3316465.pdf | N | 6.3V | X5R
Kemet | C0402C221J1GACTU | 220p | N | 0402 | Capacitor_SMD:C_0402_1005Metric | 0.5 | 2% | https://www.mouser.co.uk/datasheet/2/447/KEM_C1006_X5R_SMD-3316465.pdf | N | 100V | NP0/C0G
Kemet | C0402C180K5GACTU | 18p | N | 0402 | Capacitor_SMD:C_0402_1005Metric | 0.5 | 10% | https://www.mouser.co.uk/datasheet/2/447/KEM_C1006_X5R_SMD-3316465.pdf | N | 50V | NP0/C0G
Kemet | C0402C121K5GACTU | 120p | N | 0402 | Capacitor_SMD:C_0402_1005Metric | 0.5 | 10% | https://www.mouser.co.uk/datasheet/2/447/KEM_C1006_X5R_SMD-3316465.pdf | N | 50V | NP0/C0G
Kemet | C0402C681K5GACTU | 680p | N | 0402 | Capacitor_SMD:C_0402_1005Metric | 0.5 | 10% | https://www.mouser.co.uk/datasheet/2/447/KEM_C1006_X5R_SMD-3316465.pdf | N | 50V | NP0/C0G
Kemet | C0402C101K4GACTU | 100p | N | 0402 | Capacitor_SMD:C_0402_1005Metric | 0.5 | 10% | https://www.mouser.co.uk/datasheet/2/447/KEM_C1006_X5R_SMD-3316465.pdf | N | 16V | NP0/C0G
Kemet | C0402C470K5GACTU | 47p | N | 0402 | Capacitor_SMD:C_0402_1005Metric | 0.5 | 10% | https://www.mouser.co.uk/datasheet/2/447/KEM_C1006_X5R_SMD-3316465.pdf | N | 50V | NP0/C0G
Kemet | C0402C150J5GACTU | 15p | N | 0402 | Capacitor_SMD:C_0402_1005Metric | 0.5 | 2% | https://www.mouser.co.uk/datasheet/2/447/KEM_C1006_X5R_SMD-3316465.pdf | N | 50V | NP0/C0G
Kemet | C0402C270J5GACTU | 27p | N | 0402 | Capacitor_SMD:C_0402_1005Metric | 0.5 | 2% | https://www.mouser.co.uk/datasheet/2/447/KEM_C1006_X5R_SMD-3316465.pdf | N | 50V | NP0/C0G
Kemet | C0402C220K3GACTU | 22p | N | 0402 | Capacitor_SMD:C_0402_1005Metric | 0.5 | 10% | https://www.mouser.co.uk/datasheet/2/447/KEM_C1006_X5R_SMD-3316465.pdf | N | 25V | NP0/C0G
Kemet | C0402C121J3GACTU | 120p | N | 0402 | Capacitor_SMD:C_0402_1005Metric | 0.5 | 2% | https://www.mouser.co.uk/datasheet/2/447/KEM_C1006_X5R_SMD-3316465.pdf | N | 25V | NP0/C0G
Kemet | C0402C101K3GACTU | 100p | N | 0402 | Capacitor_SMD:C_0402_1005Metric | 0.5 | 10% | https://www.mouser.co.uk/datasheet/2/447/KEM_C1006_X5R_SMD-3316465.pdf | N | 25V | NP0/C0G
Kemet | C0402C104K4PACTU | 100n | N | 0402 | Capacitor_SMD:C_0402_1005Metric | 0.5 | 10% | https://www.mouser.co.uk/datasheet/2/447/KEM_C1006_X5R_SMD-3316465.pdf | N | 16V | X5R
Kemet | C0402C479K8GACTU | 4p7 | N | 0402 | Capacitor_SMD:C_0402_1005Metric | 0.5 | 10% | https://www.mouser.co.uk/datasheet/2/447/KEM_C1006_X5R_SMD-3316465.pdf | N | 10V | NP0/C0G
Kemet | C0402C279K3GACTU | 2p7 | N | 0402 | Capacitor_SMD:C_0402_1005Metric | 0.5 | 10% | https://www.mouser.co.uk/datasheet/2/447/KEM_C1006_X5R_SMD-3316465.pdf | N | 25V | NP0/C0G
Kemet | C0402C101G1GACTU | 100p | N | 0402 | Capacitor_SMD:C_0402_1005Metric | 0.5 | 2% | https://www.mouser.co.uk/datasheet/2/447/KEM_C1006_X5R_SMD-3316465.pdf | N | 100V | NP0/C0G
Kemet | C0402C339D5GACTU | 3p3 | N | 0402 | Capacitor_SMD:C_0402_1005Metric | 0.5 | 0.5pF | https://www.mouser.co.uk/datasheet/2/447/KEM_C1006_X5R_SMD-3316465.pdf | N | 50V | NP0/C0G
Kemet | C0402C106M9PACTU | 10u | N | 0402 | Capacitor_SMD:C_0402_1005Metric | 0.5 | 20% | https://www.mouser.co.uk/datasheet/2/447/KEM_C1006_X5R_SMD-3316465.pdf | N | 6.3V | X5R
Kemet | C0402C225M8PACTU | 2u2 | N | 0402 | Capacitor_SMD:C_0402_1005Metric | 0.5 | 20% | https://www.mouser.co.uk/datasheet/2/447/KEM_C1006_X5R_SMD-3316465.pdf | N | 10V | X5R
Kemet | C0402C102K5GACTU | 1n | N | 0402 | Capacitor_SMD:C_0402_1005Metric | 0.5 | 10% | https://www.mouser.co.uk/datasheet/2/447/KEM_C1006_X5R_SMD-3316465.pdf | N | 50V | NP0/C0G
Kemet | C0402C101J5GACTU | 100p | N | 0402 | Capacitor_SMD:C_0402_1005Metric | 0.5 | 2% | https://www.mouser.co.uk/datasheet/2/447/KEM_C1006_X5R_SMD-3316465.pdf | N | 50V | NP0/C0G
Kemet | C0402C474K9PACTU | 470n | N | 0402 | Capacitor_SMD:C_0402_1005Metric | 0.5 | 10% | https://www.mouser.co.uk/datasheet/2/447/KEM_C1006_X5R_SMD-3316465.pdf | N | 6.3V | X5R
Kemet | C0402C751J5GACTU | 750p | N | 0402 | Capacitor_SMD:C_0402_1005Metric | 0.5 | 2% | https://www.mouser.co.uk/datasheet/2/447/KEM_C1006_X5R_SMD-3316465.pdf | N | 50V | NP0/C0G
Kemet | C0402C399B5GACTU | 3p9 | N | 0402 | Capacitor_SMD:C_0402_1005Metric | 0.5 | 0.1pF | https://www.mouser.co.uk/datasheet/2/447/KEM_C1006_X5R_SMD-3316465.pdf | N | 50V | NP0/C0G
Kemet | C0402C104K7PACTU | 100n | N | 0402 | Capacitor_SMD:C_0402_1005Metric | 0.5 | 10% | https://www.mouser.co.uk/datasheet/2/447/KEM_C1006_X5R_SMD-3316465.pdf | N | 4V | X5R
Kemet | C0402C331J3GACTU | 330p | N | 0402 | Capacitor_SMD:C_0402_1005Metric | 0.5 | 2% | https://www.mouser.co.uk/datasheet/2/447/KEM_C1006_X5R_SMD-3316465.pdf | N | 25V | NP0/C0G
Kemet | C0402C222J3GACTU | 2n2 | N | 0402 | Capacitor_SMD:C_0402_1005Metric | 0.5 | 2% | https://www.mouser.co.uk/datasheet/2/447/KEM_C1006_X5R_SMD-3316465.pdf | N | 25V | NP0/C0G
Kemet | C0402C519C5GACTU | 5p1 | N | 0402 | Capacitor_SMD:C_0402_1005Metric | 0.5 | 0.25pF | https://www.mouser.co.uk/datasheet/2/447/KEM_C1006_X5R_SMD-3316465.pdf | N | 50V | NP0/C0G
Kemet | C0402C751J3GACTU | 750p | N | 0402 | Capacitor_SMD:C_0402_1005Metric | 0.5 | 2% | https://www.mouser.co.uk/datasheet/2/447/KEM_C1006_X5R_SMD-3316465.pdf | N | 25V | NP0/C0G
Kemet | C0402C330K3GACTU | 33p | N | 0402 | Capacitor_SMD:C_0402_1005Metric | 0.5 | 10% | https://www.mouser.co.uk/datasheet/2/447/KEM_C1006_X5R_SMD-3316465.pdf | N | 25V | NP0/C0G
Kemet | C0402C120G5GACTU | 12p | N | 0402 | Capacitor_SMD:C_0402_1005Metric | 0.5 | 2% | https://www.mouser.co.uk/datasheet/2/447/KEM_C1006_X5R_SMD-3316465.pdf | N | 50V | NP0/C0G
Kemet | C0402C209D5GACTU | 2p | N | 0402 | Capacitor_SMD:C_0402_1005Metric | 0.5 | 0.5pF | https://www.mouser.co.uk/datasheet/2/447/KEM_C1006_X5R_SMD-3316465.pdf | N | 50V | NP0/C0G
Kemet | C0402C131G5GACTU | 130p | N | 0402 | Capacitor_SMD:C_0402_1005Metric | 0.5 | 2% | https://www.mouser.co.uk/datasheet/2/447/KEM_C1006_X5R_SMD-3316465.pdf | N | 50V | NP0/C0G
Kemet | C0402C200J3GACTU | 20p | N | 0402 | Capacitor_SMD:C_0402_1005Metric | 0.5 | 2% | https://www.mouser.co.uk/datasheet/2/447/KEM_C1006_X5R_SMD-3316465.pdf | N | 25V | NP0/C0G
Kemet | C0402C759C5GACTU | 7p5 | N | 0402 | Capacitor_SMD:C_0402_1005Metric | 0.5 | 0.25pF | https://www.mouser.co.uk/datasheet/2/447/KEM_C1006_X5R_SMD-3316465.pdf | N | 50V | NP0/C0G
Kemet | C0402C189D5GACTU | 1p8 | N | 0402 | Capacitor_SMD:C_0402_1005Metric | 0.5 | 0.5pF | https://www.mouser.co.uk/datasheet/2/447/KEM_C1006_X5R_SMD-3316465.pdf | N | 50V | NP0/C0G
Kemet | C0402C681J1GACTU | 680p | N | 0402 | Capacitor_SMD:C_0402_1005Metric | 0.5 | 2% | https://www.mouser.co.uk/datasheet/2/447/KEM_C1006_X5R_SMD-3316465.pdf | N | 100V | NP0/C0G
Kemet | C0402C151K1GACTU | 150p | N | 0402 | Capacitor_SMD:C_0402_1005Metric | 0.5 | 10% | https://www.mouser.co.uk/datasheet/2/447/KEM_C1006_X5R_SMD-3316465.pdf | N | 100V | NP0/C0G
Kemet | C0402C683K4PACTU | 68n | N | 0402 | Capacitor_SMD:C_0402_1005Metric | 0.5 | 10% | https://www.mouser.co.uk/datasheet/2/447/KEM_C1006_X5R_SMD-3316465.pdf | N | 16V | X5R
Kemet | C0402C279K3GACTU | 2p7 | N | 0402 | Capacitor_SMD:C_0402_1005Metric | 0.5 | 10% | https://www.mouser.co.uk/datasheet/2/447/KEM_C1006_X5R_SMD-3316465.pdf | N | 25V | NP0/C0G
Kemet | C0402C101G1GACTU | 100p | N | 0402 | Capacitor_SMD:C_0402_1005Metric | 0.5 | 2% | https://www.mouser.co.uk/datasheet/2/447/KEM_C1006_X5R_SMD-3316465.pdf | N | 100V | NP0/C0G
Kemet | C0402C339D5GACTU | 3p3 | N | 0402 | Capacitor_SMD:C_0402_1005Metric | 0.5 | 0.5pF | https://www.mouser.co.uk/datasheet/2/447/KEM_C1006_X5R_SMD-3316465.pdf | N | 50V | NP0/C0G
Kemet | C0402C106M9PACTU | 10u | N | 0402 | Capacitor_SMD:C_0402_1005Metric | 0.5 | 20% | https://www.mouser.co.uk/datasheet/2/447/KEM_C1006_X5R_SMD-3316465.pdf | N | 6.3V | X5R
Kemet | C0402C225M8PACTU | 2u2 | N | 0402 | Capacitor_SMD:C_0402_1005Metric | 0.5 | 20% | https://www.mouser.co.uk/datasheet/2/447/KEM_C1006_X5R_SMD-3316465.pdf | N | 10V | X5R
Kemet | C0402C102K5GACTU | 1n | N | 0402 | Capacitor_SMD:C_0402_1005Metric | 0.5 | 10% | https://www.mouser.co.uk/datasheet/2/447/KEM_C1006_X5R_SMD-3316465.pdf | N | 50V | NP0/C0G
Kemet | C0402C101J5GACTU | 100p | N | 0402 | Capacitor_SMD:C_0402_1005Metric | 0.5 | 2% | https://www.mouser.co.uk/datasheet/2/447/KEM_C1006_X5R_SMD-3316465.pdf | N | 50V | NP0/C0G
Kemet | C0402C474K9PACTU | 470n | N | 0402 | Capacitor_SMD:C_0402_1005Metric | 0.5 | 10% | https://www.mouser.co.uk/datasheet/2/447/KEM_C1006_X5R_SMD-3316465.pdf | N | 6.3V | X5R
Kemet | C0402C751J5GACTU | 750p | N | 0402 | Capacitor_SMD:C_0402_1005Metric | 0.5 | 2% | https://www.mouser.co.uk/datasheet/2/447/KEM_C1006_X5R_SMD-3316465.pdf | N | 50V | NP0/C0G
Kemet | C0402C399B5GACTU | 3p9 | N | 0402 | Capacitor_SMD:C_0402_1005Metric | 0.5 | 0.1pF | https://www.mouser.co.uk/datasheet/2/447/KEM_C1006_X5R_SMD-3316465.pdf | N | 50V | NP0/C0G
Kemet | C0402C104K7PACTU | 100n | N | 0402 | Capacitor_SMD:C_0402_1005Metric | 0.5 | 10% | https://www.mouser.co.uk/datasheet/2/447/KEM_C1006_X5R_SMD-3316465.pdf | N | 4V | X5R
Kemet | C0402C331J3GACTU | 330p | N | 0402 | Capacitor_SMD:C_0402_1005Metric | 0.5 | 2% | https://www.mouser.co.uk/datasheet/2/447/KEM_C1006_X5R_SMD-3316465.pdf | N | 25V | NP0/C0G
Kemet | C0402C222J3GACTU | 2n2 | N | 0402 | Capacitor_SMD:C_0402_1005Metric | 0.5 | 2% | https://www.mouser.co.uk/datasheet/2/447/KEM_C1006_X5R_SMD-3316465.pdf | N | 25V | NP0/C0G
Kemet | C0402C519C5GACTU | 5p1 | N | 0402 | Capacitor_SMD:C_0402_1005Metric | 0.5 | 0.25pF | https://www.mouser.co.uk/datasheet/2/447/KEM_C1006_X5R_SMD-3316465.pdf | N | 50V | NP0/C0G
Kemet | C0402C751J3GACTU | 750p | N | 0402 | Capacitor_SMD:C_0402_1005Metric | 0.5 | 2% | https://www.mouser.co.uk/datasheet/2/447/KEM_C1006_X5R_SMD-3316465.pdf | N | 25V | NP0/C0G
Kemet | C0402C330K3GACTU | 33p | N | 0402 | Capacitor_SMD:C_0402_1005Metric | 0.5 | 10% | https://www.mouser.co.uk/datasheet/2/447/KEM_C1006_X5R_SMD-3316465.pdf | N | 25V | NP0/C0G
Kemet | C0402C120G5GACTU | 12p | N | 0402 | Capacitor_SMD:C_0402_1005Metric | 0.5 | 2% | https://www.mouser.co.uk/datasheet/2/447/KEM_C1006_X5R_SMD-3316465.pdf | N | 50V | NP0/C0G
Kemet | C0402C209D5GACTU | 2p | N | 0402 | Capacitor_SMD:C_0402_1005Metric | 0.5 | 0.5pF | https://www.mouser.co.uk/datasheet/2/447/KEM_C1006_X5R_SMD-3316465.pdf | N | 50V | NP0/C0G
Kemet | C0402C131G5GACTU | 130p | N | 0402 | Capacitor_SMD:C_0402_1005Metric | 0.5 | 2% | https://www.mouser.co.uk/datasheet/2/447/KEM_C1006_X5R_SMD-3316465.pdf | N | 50V | NP0/C0G
Kemet | C0402C200J3GACTU | 20p | N | 0402 | Capacitor_SMD:C_0402_1005Metric | 0.5 | 2% | https://www.mouser.co.uk/datasheet/2/447/KEM_C1006_X5R_SMD-3316465.pdf | N | 25V | NP0/C0G
Kemet | C0402C759C5GACTU | 7p5 | N | 0402 | Capacitor_SMD:C_0402_1005Metric | 0.5 | 0.25pF | https://www.mouser.co.uk/datasheet/2/447/KEM_C1006_X5R_SMD-3316465.pdf | N | 50V | NP0/C0G
Kemet | C0402C189D5GACTU | 1p8 | N | 0402 | Capacitor_SMD:C_0402_1005Metric | 0.5 | 0.5pF | https://www.mouser.co.uk/datasheet/2/447/KEM_C1006_X5R_SMD-3316465.pdf | N | 50V | NP0/C0G
Kemet | C0402C681J1GACTU | 680p | N | 0402 | Capacitor_SMD:C_0402_1005Metric | 0.5 | 2% | https://www.mouser.co.uk/datasheet/2/447/KEM_C1006_X5R_SMD-3316465.pdf | N | 100V | NP0/C0G
Kemet | C0402C151K1GACTU | 150p | N | 0402 | Capacitor_SMD:C_0402_1005Metric | 0.5 | 10% | https://www.mouser.co.uk/datasheet/2/447/KEM_C1006_X5R_SMD-3316465.pdf | N | 100V | NP0/C0G
Kemet | C0402C683K4PACTU | 68n | N | 0402 | Capacitor_SMD:C_0402_1005Metric | 0.5 | 10% | https://www.mouser.co.uk/datasheet/2/447/KEM_C1006_X5R_SMD-3316465.pdf | N | 16V | X5R
Kemet | C0402C100K3GACTU | 10p | N | 0402 | Capacitor_SMD:C_0402_1005Metric | 0.5 | 10% | https://www.mouser.co.uk/datasheet/2/447/KEM_C1006_X5R_SMD-3316465.pdf | N | 25V | NP0/C0G
Kemet | C0402C101K8GACTU | 100p | N | 0402 | Capacitor_SMD:C_0402_1005Metric | 0.5 | 10% | https://www.mouser.co.uk/datasheet/2/447/KEM_C1006_X5R_SMD-3316465.pdf | N | 10V | NP0/C0G
Kemet | C0402C221F5GACTU | 220p | N | 0402 | Capacitor_SMD:C_0402_1005Metric | 0.5 | 1% | https://www.mouser.co.uk/datasheet/2/447/KEM_C1006_X5R_SMD-3316465.pdf | N | 50V | NP0/C0G
Kemet | C0402C391F5GACTU | 390p | N | 0402 | Capacitor_SMD:C_0402_1005Metric | 0.5 | 1% | https://www.mouser.co.uk/datasheet/2/447/KEM_C1006_X5R_SMD-3316465.pdf | N | 50V | NP0/C0G
Kemet | C0402C102J5GACTU | 1n | N | 0402 | Capacitor_SMD:C_0402_1005Metric | 0.5 | 2% | https://www.mouser.co.uk/datasheet/2/447/KEM_C1006_X5R_SMD-3316465.pdf | N | 50V | NP0/C0G
Kemet | C0402C439C5GACTU | 4p3 | N | 0402 | Capacitor_SMD:C_0402_1005Metric | 0.5 | 0.25pF | https://www.mouser.co.uk/datasheet/2/447/KEM_C1006_X5R_SMD-3316465.pdf | N | 50V | NP0/C0G
Kemet | C0402C225M9PACTU | 2u2 | N | 0402 | Capacitor_SMD:C_0402_1005Metric | 0.5 | 20% | https://www.mouser.co.uk/datasheet/2/447/KEM_C1006_X5R_SMD-3316465.pdf | N | 6.3V | X5R
Kemet | C0402C101J1GACTU | 100p | N | 0402 | Capacitor_SMD:C_0402_1005Metric | 0.5 | 2% | https://www.mouser.co.uk/datasheet/2/447/KEM_C1006_X5R_SMD-3316465.pdf | N | 100V | NP0/C0G
Kemet | C0402C102F5GACTU | 1n | N | 0402 | Capacitor_SMD:C_0402_1005Metric | 0.5 | 1% | https://www.mouser.co.uk/datasheet/2/447/KEM_C1006_X5R_SMD-3316465.pdf | N | 50V | NP0/C0G
Kemet | C0402C689J5GACTU | 6p8 | N | 0402 | Capacitor_SMD:C_0402_1005Metric | 0.5 | 2% | https://www.mouser.co.uk/datasheet/2/447/KEM_C1006_X5R_SMD-3316465.pdf | N | 50V | NP0/C0G
Kemet | C0402C470J8GACTU | 47p | N | 0402 | Capacitor_SMD:C_0402_1005Metric | 0.5 | 2% | https://www.mouser.co.uk/datasheet/2/447/KEM_C1006_X5R_SMD-3316465.pdf | N | 10V | NP0/C0G
Kemet | C0402C471K1GACTU | 470p | N | 0402 | Capacitor_SMD:C_0402_1005Metric | 0.5 | 10% | https://www.mouser.co.uk/datasheet/2/447/KEM_C1006_X5R_SMD-3316465.pdf | N | 100V | NP0/C0G
Kemet | C0402C104M4PACTU | 100n | N | 0402 | Capacitor_SMD:C_0402_1005Metric | 0.5 | 20% | https://www.mouser.co.uk/datasheet/2/447/KEM_C1006_X5R_SMD-3316465.pdf | N | 16V | X5R
Kemet | C0402C430J5GACTU | 43p | N | 0402 | Capacitor_SMD:C_0402_1005Metric | 0.5 | 2% | https://www.mouser.co.uk/datasheet/2/447/KEM_C1006_X5R_SMD-3316465.pdf | N | 50V | NP0/C0G
Kemet | C0402C369C5GACTU | 3p6 | N | 0402 | Capacitor_SMD:C_0402_1005Metric | 0.5 | 0.25pF | https://www.mouser.co.uk/datasheet/2/447/KEM_C1006_X5R_SMD-3316465.pdf | N | 50V | NP0/C0G
Kemet | C0402C560F5GACTU | 56p | N | 0402 | Capacitor_SMD:C_0402_1005Metric | 0.5 | 1% | https://www.mouser.co.uk/datasheet/2/447/KEM_C1006_X5R_SMD-3316465.pdf | N | 50V | NP0/C0G
Kemet | C0402C105K4PACTU | 1u | N | 0402 | Capacitor_SMD:C_0402_1005Metric | 0.5 | 10% | https://www.mouser.co.uk/datasheet/2/447/KEM_C1006_X5R_SMD-3316465.pdf | N | 16V | X5R
Kemet | C0402C223K4PACTU | 22n | N | 0402 | Capacitor_SMD:C_0402_1005Metric | 0.5 | 10% | https://www.mouser.co.uk/datasheet/2/447/KEM_C1006_X5R_SMD-3316465.pdf | N | 16V | X5R
Kemet | C0402C103K8PACTU | 10n | N | 0402 | Capacitor_SMD:C_0402_1005Metric | 0.5 | 10% | https://www.mouser.co.uk/datasheet/2/447/KEM_C1006_X5R_SMD-3316465.pdf | N | 10V | X5R
Kemet | C0402C563K8PACTU | 56n | N | 0402 | Capacitor_SMD:C_0402_1005Metric | 0.5 | 10% | https://www.mouser.co.uk/datasheet/2/447/KEM_C1006_X5R_SMD-3316465.pdf | N | 10V | X5R
Kemet | C0402C820J5GACTU | 82p | N | 0402 | Capacitor_SMD:C_0402_1005Metric | 0.5 | 2% | https://www.mouser.co.uk/datasheet/2/447/KEM_C1006_X5R_SMD-3316465.pdf | N | 50V | NP0/C0G
Kemet | C0402C473K8PACTU | 47n | N | 0402 | Capacitor_SMD:C_0402_1005Metric | 0.5 | 10% | https://www.mouser.co.uk/datasheet/2/447/KEM_C1006_X5R_SMD-3316465.pdf | N | 10V | X5R
Kemet | C0402C759B5GACTU | 7p5 | N | 0402 | Capacitor_SMD:C_0402_1005Metric | 0.5 | 0.1pF | https://www.mouser.co.uk/datasheet/2/447/KEM_C1006_X5R_SMD-3316465.pdf | N | 50V | NP0/C0G
Kemet | C0402C331GAGACTU | 330p | N | 0402 | Capacitor_SMD:C_0402_1005Metric | 0.5 | 2% | https://www.mouser.co.uk/datasheet/2/447/KEM_C1006_X5R_SMD-3316465.pdf | N | 250V | NP0/C0G
Kemet | C0402C241G5GACTU | 240p | N | 0402 | Capacitor_SMD:C_0402_1005Metric | 0.5 | 2% | https://www.mouser.co.uk/datasheet/2/447/KEM_C1006_X5R_SMD-3316465.pdf | N | 50V | NP0/C0G
Kemet | C0402C821F5GACTU | 820p | N | 0402 | Capacitor_SMD:C_0402_1005Metric | 0.5 | 1% | https://www.mouser.co.uk/datasheet/2/447/KEM_C1006_X5R_SMD-3316465.pdf | N | 50V | NP0/C0G
Kemet | C0402C820J3GACTU | 82p | N | 0402 | Capacitor_SMD:C_0402_1005Metric | 0.5 | 2% | https://www.mouser.co.uk/datasheet/2/447/KEM_C1006_X5R_SMD-3316465.pdf | N | 25V | NP0/C0G
Kemet | C0402C102K8GACTU | 1n | N | 0402 | Capacitor_SMD:C_0402_1005Metric | 0.5 | 10% | https://www.mouser.co.uk/datasheet/2/447/KEM_C1006_X5R_SMD-3316465.pdf | N | 10V | NP0/C0G
Kemet | C0402C100J4GACTU | 10p | N | 0402 | Capacitor_SMD:C_0402_1005Metric | 0.5 | 2% | https://www.mouser.co.uk/datasheet/2/447/KEM_C1006_X5R_SMD-3316465.pdf | N | 16V | NP0/C0G
Kemet | C0402C471G5GACTU | 470p | N | 0402 | Capacitor_SMD:C_0402_1005Metric | 0.5 | 2% | https://www.mouser.co.uk/datasheet/2/447/KEM_C1006_X5R_SMD-3316465.pdf | N | 50V | NP0/C0G
Kemet | C0402C105K9PACTU | 1u | N | 0402 | Capacitor_SMD:C_0402_1005Metric | 0.5 | 10% | https://www.mouser.co.uk/datasheet/2/447/KEM_C1006_X5R_SMD-3316465.pdf | N | 6.3V | X5R
Kemet | C0402C202J3GACTU | 2n | N | 0402 | Capacitor_SMD:C_0402_1005Metric | 0.5 | 2% | https://www.mouser.co.uk/datasheet/2/447/KEM_C1006_X5R_SMD-3316465.pdf | N | 25V | NP0/C0G
Kemet | C0402C391J5GACTU | 390p | N | 0402 | Capacitor_SMD:C_0402_1005Metric | 0.5 | 2% | https://www.mouser.co.uk/datasheet/2/447/KEM_C1006_X5R_SMD-3316465.pdf | N | 50V | NP0/C0G
Kemet | C0402C680F5GACTU | 68p | N | 0402 | Capacitor_SMD:C_0402_1005Metric | 0.5 | 1% | https://www.mouser.co.uk/datasheet/2/447/KEM_C1006_X5R_SMD-3316465.pdf | N | 50V | NP0/C0G
Kemet | C0402C110J5GACTU | 11p | N | 0402 | Capacitor_SMD:C_0402_1005Metric | 0.5 | 2% | https://www.mouser.co.uk/datasheet/2/447/KEM_C1006_X5R_SMD-3316465.pdf | N | 50V | NP0/C0G
Kemet | C0402C393K8PACTU | 39n | N | 0402 | Capacitor_SMD:C_0402_1005Metric | 0.5 | 10% | https://www.mouser.co.uk/datasheet/2/447/KEM_C1006_X5R_SMD-3316465.pdf | N | 10V | X5R
Kemet | C0402C689B5GACTU | 6p8 | N | 0402 | Capacitor_SMD:C_0402_1005Metric | 0.5 | 0.1pF | https://www.mouser.co.uk/datasheet/2/447/KEM_C1006_X5R_SMD-3316465.pdf | N | 50V | NP0/C0G
Kemet | C0402C279B5GACTU | 2p7 | N | 0402 | Capacitor_SMD:C_0402_1005Metric | 0.5 | 0.1pF | https://www.mouser.co.uk/datasheet/2/447/KEM_C1006_X5R_SMD-3316465.pdf | N | 50V | NP0/C0G
Kemet | C0402C201J5GACTU | 200p | N | 0402 | Capacitor_SMD:C_0402_1005Metric | 0.5 | 2% | https://www.mouser.co.uk/datasheet/2/447/KEM_C1006_X5R_SMD-3316465.pdf | N | 50V | NP0/C0G
Kemet | C0402C159B5GACTU | 1p5 | N | 0402 | Capacitor_SMD:C_0402_1005Metric | 0.5 | 0.1pF | https://www.mouser.co.uk/datasheet/2/447/KEM_C1006_X5R_SMD-3316465.pdf | N | 50V | NP0/C0G
Kemet | C0402C225K7PACTU | 2u2 | N | 0402 | Capacitor_SMD:C_0402_1005Metric | 0.5 | 10% | https://www.mouser.co.uk/datasheet/2/447/KEM_C1006_X5R_SMD-3316465.pdf | N | 4V | X5R
Kemet | C0402C229B3GACTU | 2p2 | N | 0402 | Capacitor_SMD:C_0402_1005Metric | 0.5 | 0.1pF | https://www.mouser.co.uk/datasheet/2/447/KEM_C1006_X5R_SMD-3316465.pdf | N | 25V | NP0/C0G
Kemet | C0402C151J4GACTU | 150p | N | 0402 | Capacitor_SMD:C_0402_1005Metric | 0.5 | 2% | https://www.mouser.co.uk/datasheet/2/447/KEM_C1006_X5R_SMD-3316465.pdf | N | 16V | NP0/C0G
Kemet | C0402C519K4GACTU | 5p1 | N | 0402 | Capacitor_SMD:C_0402_1005Metric | 0.5 | 10% | https://www.mouser.co.uk/datasheet/2/447/KEM_C1006_X5R_SMD-3316465.pdf | N | 16V | NP0/C0G
Kemet | C0402C220K4GACTU | 22p | N | 0402 | Capacitor_SMD:C_0402_1005Metric | 0.5 | 10% | https://www.mouser.co.uk/datasheet/2/447/KEM_C1006_X5R_SMD-3316465.pdf | N | 16V | NP0/C0G
Kemet | C0402C152K3GACTU | 1n5 | N | 0402 | Capacitor_SMD:C_0402_1005Metric | 0.5 | 10% | https://www.mouser.co.uk/datasheet/2/447/KEM_C1006_X5R_SMD-3316465.pdf | N | 25V | NP0/C0G
Kemet | C0402C220C5GACTU | 22p | N | 0402 | Capacitor_SMD:C_0402_1005Metric | 0.5 | 0.25pF | https://www.mouser.co.uk/datasheet/2/447/KEM_C1006_X5R_SMD-3316465.pdf | N | 50V | NP0/C0G
Kemet | C0402C910J5GACTU | 91p | N | 0402 | Capacitor_SMD:C_0402_1005Metric | 0.5 | 2% | https://www.mouser.co.uk/datasheet/2/447/KEM_C1006_X5R_SMD-3316465.pdf | N | 50V | NP0/C0G
Kemet | C0402C273K8PACTU | 27n | N | 0402 | Capacitor_SMD:C_0402_1005Metric | 0.5 | 10% | https://www.mouser.co.uk/datasheet/2/447/KEM_C1006_X5R_SMD-3316465.pdf | N | 10V | X5R
Kemet | C0402C100D4GACTU | 10p | N | 0402 | Capacitor_SMD:C_0402_1005Metric | 0.5 | 0.5pF | https://www.mouser.co.uk/datasheet/2/447/KEM_C1006_X5R_SMD-3316465.pdf | N | 16V | NP0/C0G
Kemet | C0402C100J5GACTU | 10p | N | 0402 | Capacitor_SMD:C_0402_1005Metric | 0.5 | 2% | https://www.mouser.co.uk/datasheet/2/447/KEM_C1006_X5R_SMD-3316465.pdf | N | 50V | NP0/C0G
Kemet | C0402C200K8GACTU | 20p | N | 0402 | Capacitor_SMD:C_0402_1005Metric | 0.5 | 10% | https://www.mouser.co.uk/datasheet/2/447/KEM_C1006_X5R_SMD-3316465.pdf | N | 10V | NP0/C0G
Kemet | C0402C470K3GACTU | 47p | N | 0402 | Capacitor_SMD:C_0402_1005Metric | 0.5 | 10% | https://www.mouser.co.uk/datasheet/2/447/KEM_C1006_X5R_SMD-3316465.pdf | N | 25V | NP0/C0G
Kemet | C0402C829J5GACTU | 8p2 | N | 0402 | Capacitor_SMD:C_0402_1005Metric | 0.5 | 2% | https://www.mouser.co.uk/datasheet/2/447/KEM_C1006_X5R_SMD-3316465.pdf | N | 50V | NP0/C0G
Kemet | C0402C151F5GACTU | 150p | N | 0402 | Capacitor_SMD:C_0402_1005Metric | 0.5 | 1% | https://www.mouser.co.uk/datasheet/2/447/KEM_C1006_X5R_SMD-3316465.pdf | N | 50V | NP0/C0G
Kemet | C0402C180G5GACTU | 18p | N | 0402 | Capacitor_SMD:C_0402_1005Metric | 0.5 | 2% | https://www.mouser.co.uk/datasheet/2/447/KEM_C1006_X5R_SMD-3316465.pdf | N | 50V | NP0/C0G
Kemet | C0402C183K8PACTU | 18n | N | 0402 | Capacitor_SMD:C_0402_1005Metric | 0.5 | 10% | https://www.mouser.co.uk/datasheet/2/447/KEM_C1006_X5R_SMD-3316465.pdf | N | 10V | X5R
Kemet | C0402C101G5GACTU | 100p | N | 0402 | Capacitor_SMD:C_0402_1005Metric | 0.5 | 2% | https://www.mouser.co.uk/datasheet/2/447/KEM_C1006_X5R_SMD-3316465.pdf | N | 50V | NP0/C0G
Kemet | C0402C153K8PACTU | 15n | N | 0402 | Capacitor_SMD:C_0402_1005Metric | 0.5 | 10% | https://www.mouser.co.uk/datasheet/2/447/KEM_C1006_X5R_SMD-3316465.pdf | N | 10V | X5R
Kemet | C0402C475M9PACTU | 4u7 | N | 0402 | Capacitor_SMD:C_0402_1005Metric | 0.5 | 20% | https://www.mouser.co.uk/datasheet/2/447/KEM_C1006_X5R_SMD-3316465.pdf | N | 6.3V | X5R
Kemet | C0402C101F1GACTU | 100p | N | 0402 | Capacitor_SMD:C_0402_1005Metric | 0.5 | 1% | https://www.mouser.co.uk/datasheet/2/447/KEM_C1006_X5R_SMD-3316465.pdf | N | 100V | NP0/C0G
Kemet | C0402C181F5GACTU | 180p | N | 0402 | Capacitor_SMD:C_0402_1005Metric | 0.5 | 1% | https://www.mouser.co.uk/datasheet/2/447/KEM_C1006_X5R_SMD-3316465.pdf | N | 50V | NP0/C0G
Kemet | C0402C102J1GACTU | 1n | N | 0402 | Capacitor_SMD:C_0402_1005Metric | 0.5 | 2% | https://www.mouser.co.uk/datasheet/2/447/KEM_C1006_X5R_SMD-3316465.pdf | N | 100V | NP0/C0G
Kemet | C0402C470J3GACTU | 47p | N | 0402 | Capacitor_SMD:C_0402_1005Metric | 0.5 | 2% | https://www.mouser.co.uk/datasheet/2/447/KEM_C1006_X5R_SMD-3316465.pdf | N | 25V | NP0/C0G
Kemet | C0402C160J3GACTU | 16p | N | 0402 | Capacitor_SMD:C_0402_1005Metric | 0.5 | 2% | https://www.mouser.co.uk/datasheet/2/447/KEM_C1006_X5R_SMD-3316465.pdf | N | 25V | NP0/C0G
Kemet | C0402C471J5GACTU | 470p | N | 0402 | Capacitor_SMD:C_0402_1005Metric | 0.5 | 2% | https://www.mouser.co.uk/datasheet/2/447/KEM_C1006_X5R_SMD-3316465.pdf | N | 50V | NP0/C0G
Kemet | C0402C470K8GACTU | 47p | N | 0402 | Capacitor_SMD:C_0402_1005Metric | 0.5 | 10% | https://www.mouser.co.uk/datasheet/2/447/KEM_C1006_X5R_SMD-3316465.pdf | N | 10V | NP0/C0G
Kemet | C0402C105M8PACTU | 1u | N | 0402 | Capacitor_SMD:C_0402_1005Metric | 0.5 | 20% | https://www.mouser.co.uk/datasheet/2/447/KEM_C1006_X5R_SMD-3316465.pdf | N | 10V | X5R
Kemet | C0402C105K8PACTU | 1u | N | 0402 | Capacitor_SMD:C_0402_1005Metric | 0.5 | 10% | https://www.mouser.co.uk/datasheet/2/447/KEM_C1006_X5R_SMD-3316465.pdf | N | 10V | X5R
Kemet | C0402C271J3GACTU | 270p | N | 0402 | Capacitor_SMD:C_0402_1005Metric | 0.5 | 2% | https://www.mouser.co.uk/datasheet/2/447/KEM_C1006_X5R_SMD-3316465.pdf | N | 25V | NP0/C0G
Kemet | C0402C102J8GACTU | 1n | N | 0402 | Capacitor_SMD:C_0402_1005Metric | 0.5 | 2% | https://www.mouser.co.uk/datasheet/2/447/KEM_C1006_X5R_SMD-3316465.pdf | N | 10V | NP0/C0G
Kemet | C0402C181J3GACTU | 180p | N | 0402 | Capacitor_SMD:C_0402_1005Metric | 0.5 | 2% | https://www.mouser.co.uk/datasheet/2/447/KEM_C1006_X5R_SMD-3316465.pdf | N | 25V | NP0/C0G
Kemet | C0402C508B5GACTU | 0p5 | N | 0402 | Capacitor_SMD:C_0402_1005Metric | 0.5 | 0.1pF | https://www.mouser.co.uk/datasheet/2/447/KEM_C1006_X5R_SMD-3316465.pdf | N | 50V | NP0/C0G
Kemet | C0402C479B5GACTU | 4p7 | N | 0402 | Capacitor_SMD:C_0402_1005Metric | 0.5 | 0.1pF | https://www.mouser.co.uk/datasheet/2/447/KEM_C1006_X5R_SMD-3316465.pdf | N | 50V | NP0/C0G
Kemet | C0402C189B5GACTU | 1p8 | N | 0402 | Capacitor_SMD:C_0402_1005Metric | 0.5 | 0.1pF | https://www.mouser.co.uk/datasheet/2/447/KEM_C1006_X5R_SMD-3316465.pdf | N | 50V | NP0/C0G
Kemet | C0402C301F2GACTU | 300p | N | 0402 | Capacitor_SMD:C_0402_1005Metric | 0.5 | 1% | https://www.mouser.co.uk/datasheet/2/447/KEM_C1006_X5R_SMD-3316465.pdf | N | 200V | NP0/C0G
Kemet | C0402C220F5GACTU | 22p | N | 0402 | Capacitor_SMD:C_0402_1005Metric | 0.5 | 1% | https://www.mouser.co.uk/datasheet/2/447/KEM_C1006_X5R_SMD-3316465.pdf | N | 50V | NP0/C0G
Kemet | C0402C104K8PACTU | 100n | N | 0402 | Capacitor_SMD:C_0402_1005Metric | 0.5 | 10% | https://www.mouser.co.uk/datasheet/2/447/KEM_C1006_X5R_SMD-3316465.pdf | N | 10V | X5R
Kemet | C0402C470F5GACTU | 47p | N | 0402 | Capacitor_SMD:C_0402_1005Metric | 0.5 | 1% | https://www.mouser.co.uk/datasheet/2/447/KEM_C1006_X5R_SMD-3316465.pdf | N | 50V | NP0/C0G
Kemet | C0402C100G5GACTU | 10p | N | 0402 | Capacitor_SMD:C_0402_1005Metric | 0.5 | 2% | https://www.mouser.co.uk/datasheet/2/447/KEM_C1006_X5R_SMD-3316465.pdf | N | 50V | NP0/C0G
Kemet | C0402C112J5GACTU | 1n1 | N | 0402 | Capacitor_SMD:C_0402_1005Metric | 0.5 | 2% | https://www.mouser.co.uk/datasheet/2/447/KEM_C1006_X5R_SMD-3316465.pdf | N | 50V | NP0/C0G
Kemet | C0402C222F4GACTU | 2n2 | N | 0402 | Capacitor_SMD:C_0402_1005Metric | 0.5 | 1% | https://www.mouser.co.uk/datasheet/2/447/KEM_C1006_X5R_SMD-3316465.pdf | N | 16V | NP0/C0G
Kemet | C0402C331J4GACTU | 330p | N | 0402 | Capacitor_SMD:C_0402_1005Metric | 0.5 | 2% | https://www.mouser.co.uk/datasheet/2/447/KEM_C1006_X5R_SMD-3316465.pdf | N | 16V | NP0/C0G
Kemet | C0402C150D5GACTU | 15p | N | 0402 | Capacitor_SMD:C_0402_1005Metric | 0.5 | 0.5pF | https://www.mouser.co.uk/datasheet/2/447/KEM_C1006_X5R_SMD-3316465.pdf | N | 50V | NP0/C0G
Kemet | C0402C229D5GACTU | 2p2 | N | 0402 | Capacitor_SMD:C_0402_1005Metric | 0.5 | 0.5pF | https://www.mouser.co.uk/datasheet/2/447/KEM_C1006_X5R_SMD-3316465.pdf | N | 50V | NP0/C0G
Kemet | C0402C120G3GACTU | 12p | N | 0402 | Capacitor_SMD:C_0402_1005Metric | 0.5 | 2% | https://www.mouser.co.uk/datasheet/2/447/KEM_C1006_X5R_SMD-3316465.pdf | N | 25V | NP0/C0G
Kemet | C0402C160G5GACTU | 16p | N | 0402 | Capacitor_SMD:C_0402_1005Metric | 0.5 | 2% | https://www.mouser.co.uk/datasheet/2/447/KEM_C1006_X5R_SMD-3316465.pdf | N | 50V | NP0/C0G
Kemet | C0402C222K3GACTU | 2n2 | N | 0402 | Capacitor_SMD:C_0402_1005Metric | 0.5 | 10% | https://www.mouser.co.uk/datasheet/2/447/KEM_C1006_X5R_SMD-3316465.pdf | N | 25V | NP0/C0G
Kemet | C0402C111J2GACTU | 110p | N | 0402 | Capacitor_SMD:C_0402_1005Metric | 0.5 | 2% | https://www.mouser.co.uk/datasheet/2/447/KEM_C1006_X5R_SMD-3316465.pdf | N | 200V | NP0/C0G
Kemet | C0402C271F5GACTU | 270p | N | 0402 | Capacitor_SMD:C_0402_1005Metric | 0.5 | 1% | https://www.mouser.co.uk/datasheet/2/447/KEM_C1006_X5R_SMD-3316465.pdf | N | 50V | NP0/C0G
Kemet | C0402C151G5GACTU | 150p | N | 0402 | Capacitor_SMD:C_0402_1005Metric | 0.5 | 2% | https://www.mouser.co.uk/datasheet/2/447/KEM_C1006_X5R_SMD-3316465.pdf | N | 50V | NP0/C0G
Kemet | C0402C911G3GACTU | 910p | N | 0402 | Capacitor_SMD:C_0402_1005Metric | 0.5 | 2% | https://www.mouser.co.uk/datasheet/2/447/KEM_C1006_X5R_SMD-3316465.pdf | N | 25V | NP0/C0G
Kemet | C0402C150K3GACTU | 15p | N | 0402 | Capacitor_SMD:C_0402_1005Metric | 0.5 | 10% | https://www.mouser.co.uk/datasheet/2/447/KEM_C1006_X5R_SMD-3316465.pdf | N | 25V | NP0/C0G
Kemet | C0402C560K5GACTU | 56p | N | 0402 | Capacitor_SMD:C_0402_1005Metric | 0.5 | 10% | https://www.mouser.co.uk/datasheet/2/447/KEM_C1006_X5R_SMD-3316465.pdf | N | 50V | NP0/C0G
Kemet | C0402C279C4GACTU | 2p7 | N | 0402 | Capacitor_SMD:C_0402_1005Metric | 0.5 | 0.25pF | https://www.mouser.co.uk/datasheet/2/447/KEM_C1006_X5R_SMD-3316465.pdf | N | 16V | NP0/C0G
Kemet | C0402C569C3GACTU | 5p6 | N | 0402 | Capacitor_SMD:C_0402_1005Metric | 0.5 | 0.25pF | https://www.mouser.co.uk/datasheet/2/447/KEM_C1006_X5R_SMD-3316465.pdf | N | 25V | NP0/C0G
Kemet | C0402C100K8GACTU | 10p | N | 0402 | Capacitor_SMD:C_0402_1005Metric | 0.5 | 10% | https://www.mouser.co.uk/datasheet/2/447/KEM_C1006_X5R_SMD-3316465.pdf | N | 10V | NP0/C0G
Kemet | C0402C330F5GACTU | 33p | N | 0402 | Capacitor_SMD:C_0402_1005Metric | 0.5 | 1% | https://www.mouser.co.uk/datasheet/2/447/KEM_C1006_X5R_SMD-3316465.pdf | N | 50V | NP0/C0G
Kemet | C0402C101F5GACTU | 100p | N | 0402 | Capacitor_SMD:C_0402_1005Metric | 0.5 | 1% | https://www.mouser.co.uk/datasheet/2/447/KEM_C1006_X5R_SMD-3316465.pdf | N | 50V | NP0/C0G
Kemet | C0402C561J5GACTU | 560p | N | 0402 | Capacitor_SMD:C_0402_1005Metric | 0.5 | 2% | https://www.mouser.co.uk/datasheet/2/447/KEM_C1006_X5R_SMD-3316465.pdf | N | 50V | NP0/C0G
Kemet | C0402C121K1GACTU | 120p | N | 0402 | Capacitor_SMD:C_0402_1005Metric | 0.5 | 10% | https://www.mouser.co.uk/datasheet/2/447/KEM_C1006_X5R_SMD-3316465.pdf | N | 100V | NP0/C0G
Kemet | C0402C129D5GACTU | 1p2 | N | 0402 | Capacitor_SMD:C_0402_1005Metric | 0.5 | 0.5pF | https://www.mouser.co.uk/datasheet/2/447/KEM_C1006_X5R_SMD-3316465.pdf | N | 50V | NP0/C0G
Kemet | C0402C119C5GACTU | 1p1 | N | 0402 | Capacitor_SMD:C_0402_1005Metric | 0.5 | 0.25pF | https://www.mouser.co.uk/datasheet/2/447/KEM_C1006_X5R_SMD-3316465.pdf | N | 50V | NP0/C0G
Kemet | C0402C270G5GACTU | 27p | N | 0402 | Capacitor_SMD:C_0402_1005Metric | 0.5 | 2% | https://www.mouser.co.uk/datasheet/2/447/KEM_C1006_X5R_SMD-3316465.pdf | N | 50V | NP0/C0G
Kemet | C0402C391G5GACTU | 390p | N | 0402 | Capacitor_SMD:C_0402_1005Metric | 0.5 | 2% | https://www.mouser.co.uk/datasheet/2/447/KEM_C1006_X5R_SMD-3316465.pdf | N | 50V | NP0/C0G
Kemet | C0402C689C3GACTU | 6p8 | N | 0402 | Capacitor_SMD:C_0402_1005Metric | 0.5 | 0.25pF | https://www.mouser.co.uk/datasheet/2/447/KEM_C1006_X5R_SMD-3316465.pdf | N | 25V | NP0/C0G
Kemet | C0402C508D5GACTU | 0p5 | N | 0402 | Capacitor_SMD:C_0402_1005Metric | 0.5 | 0.5pF | https://www.mouser.co.uk/datasheet/2/447/KEM_C1006_X5R_SMD-3316465.pdf | N | 50V | NP0/C0G
Kemet | C0402C561G5GACTU | 560p | N | 0402 | Capacitor_SMD:C_0402_1005Metric | 0.5 | 2% | https://www.mouser.co.uk/datasheet/2/447/KEM_C1006_X5R_SMD-3316465.pdf | N | 50V | NP0/C0G
Kemet | C0402C829C3GACTU | 8p2 | N | 0402 | Capacitor_SMD:C_0402_1005Metric | 0.5 | 0.25pF | https://www.mouser.co.uk/datasheet/2/447/KEM_C1006_X5R_SMD-3316465.pdf | N | 25V | NP0/C0G
Kemet | C0402C339C3GACTU | 3p3 | N | 0402 | Capacitor_SMD:C_0402_1005Metric | 0.5 | 0.25pF | https://www.mouser.co.uk/datasheet/2/447/KEM_C1006_X5R_SMD-3316465.pdf | N | 25V | NP0/C0G
Kemet | C0402C249D5GACTU | 2p4 | N | 0402 | Capacitor_SMD:C_0402_1005Metric | 0.5 | 0.5pF | https://www.mouser.co.uk/datasheet/2/447/KEM_C1006_X5R_SMD-3316465.pdf | N | 50V | NP0/C0G
Kemet | C0402C680K5GACTU | 68p | N | 0402 | Capacitor_SMD:C_0402_1005Metric | 0.5 | 10% | https://www.mouser.co.uk/datasheet/2/447/KEM_C1006_X5R_SMD-3316465.pdf | N | 50V | NP0/C0G
Kemet | C0402C829D3GACTU | 8p2 | N | 0402 | Capacitor_SMD:C_0402_1005Metric | 0.5 | 0.5pF | https://www.mouser.co.uk/datasheet/2/447/KEM_C1006_X5R_SMD-3316465.pdf | N | 25V | NP0/C0G
Kemet | C0402C683K9PACTU | 68n | N | 0402 | Capacitor_SMD:C_0402_1005Metric | 0.5 | 10% | https://www.mouser.co.uk/datasheet/2/447/KEM_C1006_X5R_SMD-3316465.pdf | N | 6.3V | X5R
Kemet | C0402C569B5GACTU | 5p6 | N | 0402 | Capacitor_SMD:C_0402_1005Metric | 0.5 | 0.1pF | https://www.mouser.co.uk/datasheet/2/447/KEM_C1006_X5R_SMD-3316465.pdf | N | 50V | NP0/C0G
Kemet | C0402C121J1GACTU | 120p | N | 0402 | Capacitor_SMD:C_0402_1005Metric | 0.5 | 2% | https://www.mouser.co.uk/datasheet/2/447/KEM_C1006_X5R_SMD-3316465.pdf | N | 100V | NP0/C0G
Kemet | C0402C101JAGACTU | 100p | N | 0402 | Capacitor_SMD:C_0402_1005Metric | 0.5 | 2% | https://www.mouser.co.uk/datasheet/2/447/KEM_C1006_X5R_SMD-3316465.pdf | N | 250V | NP0/C0G
Kemet | C0402C681F5GACTU | 680p | N | 0402 | Capacitor_SMD:C_0402_1005Metric | 0.5 | 1% | https://www.mouser.co.uk/datasheet/2/447/KEM_C1006_X5R_SMD-3316465.pdf | N | 50V | NP0/C0G
Kemet | C0402C681J3GACTU | 680p | N | 0402 | Capacitor_SMD:C_0402_1005Metric | 0.5 | 2% | https://www.mouser.co.uk/datasheet/2/447/KEM_C1006_X5R_SMD-3316465.pdf | N | 25V | NP0/C0G
Kemet | C0402C100D3GACTU | 10p | N | 0402 | Capacitor_SMD:C_0402_1005Metric | 0.5 | 0.5pF | https://www.mouser.co.uk/datasheet/2/447/KEM_C1006_X5R_SMD-3316465.pdf | N | 25V | NP0/C0G
Kemet | C0402C470G5GACTU | 47p | N | 0402 | Capacitor_SMD:C_0402_1005Metric | 0.5 | 2% | https://www.mouser.co.uk/datasheet/2/447/KEM_C1006_X5R_SMD-3316465.pdf | N | 50V | NP0/C0G
Kemet | C0402C390F5GACTU | 39p | N | 0402 | Capacitor_SMD:C_0402_1005Metric | 0.5 | 1% | https://www.mouser.co.uk/datasheet/2/447/KEM_C1006_X5R_SMD-3316465.pdf | N | 50V | NP0/C0G
Kemet | C0402C103K9PACTU | 10n | N | 0402 | Capacitor_SMD:C_0402_1005Metric | 0.5 | 10% | https://www.mouser.co.uk/datasheet/2/447/KEM_C1006_X5R_SMD-3316465.pdf | N | 6.3V | X5R
Kemet | C0402C240J3GACTU | 24p | N | 0402 | Capacitor_SMD:C_0402_1005Metric | 0.5 | 2% | https://www.mouser.co.uk/datasheet/2/447/KEM_C1006_X5R_SMD-3316465.pdf | N | 25V | NP0/C0G
Kemet | C0402C330J5GACTU | 33p | N | 0402 | Capacitor_SMD:C_0402_1005Metric | 0.5 | 2% | https://www.mouser.co.uk/datasheet/2/447/KEM_C1006_X5R_SMD-3316465.pdf | N | 50V | NP0/C0G
Kemet | C0402C330F3GACTU | 33p | N | 0402 | Capacitor_SMD:C_0402_1005Metric | 0.5 | 1% | https://www.mouser.co.uk/datasheet/2/447/KEM_C1006_X5R_SMD-3316465.pdf | N | 25V | NP0/C0G
Kemet | C0402C150F5GACTU | 15p | N | 0402 | Capacitor_SMD:C_0402_1005Metric | 0.5 | 1% | https://www.mouser.co.uk/datasheet/2/447/KEM_C1006_X5R_SMD-3316465.pdf | N | 50V | NP0/C0G
Kemet | C0402C279D5GACTU | 2p7 | N | 0402 | Capacitor_SMD:C_0402_1005Metric | 0.5 | 0.5pF | https://www.mouser.co.uk/datasheet/2/447/KEM_C1006_X5R_SMD-3316465.pdf | N | 50V | NP0/C0G
Kemet | C0402C680K8GACTU | 68p | N | 0402 | Capacitor_SMD:C_0402_1005Metric | 0.5 | 10% | https://www.mouser.co.uk/datasheet/2/447/KEM_C1006_X5R_SMD-3316465.pdf | N | 10V | NP0/C0G
Kemet | C0402C180K8GACTU | 18p | N | 0402 | Capacitor_SMD:C_0402_1005Metric | 0.5 | 10% | https://www.mouser.co.uk/datasheet/2/447/KEM_C1006_X5R_SMD-3316465.pdf | N | 10V | NP0/C0G
Kemet | C0402C241G2GACTU | 240p | N | 0402 | Capacitor_SMD:C_0402_1005Metric | 0.5 | 2% | https://www.mouser.co.uk/datasheet/2/447/KEM_C1006_X5R_SMD-3316465.pdf | N | 200V | NP0/C0G
Kemet | C0402C270K3GACTU | 27p | N | 0402 | Capacitor_SMD:C_0402_1005Metric | 0.5 | 10% | https://www.mouser.co.uk/datasheet/2/447/KEM_C1006_X5R_SMD-3316465.pdf | N | 25V | NP0/C0G
Kemet | C0402C180J8GACTU | 18p | N | 0402 | Capacitor_SMD:C_0402_1005Metric | 0.5 | 2% | https://www.mouser.co.uk/datasheet/2/447/KEM_C1006_X5R_SMD-3316465.pdf | N | 10V | NP0/C0G
Kemet | C0402C479D4GACTU | 4p7 | N | 0402 | Capacitor_SMD:C_0402_1005Metric | 0.5 | 0.5pF | https://www.mouser.co.uk/datasheet/2/447/KEM_C1006_X5R_SMD-3316465.pdf | N | 16V | NP0/C0G
Kemet | C0402C390K4GACTU | 39p | N | 0402 | Capacitor_SMD:C_0402_1005Metric | 0.5 | 10% | https://www.mouser.co.uk/datasheet/2/447/KEM_C1006_X5R_SMD-3316465.pdf | N | 16V | NP0/C0G
Kemet | C0402C820J4GACTU | 82p | N | 0402 | Capacitor_SMD:C_0402_1005Metric | 0.5 | 2% | https://www.mouser.co.uk/datasheet/2/447/KEM_C1006_X5R_SMD-3316465.pdf | N | 16V | NP0/C0G
Kemet | C0402C331K1GACTU | 330p | N | 0402 | Capacitor_SMD:C_0402_1005Metric | 0.5 | 10% | https://www.mouser.co.uk/datasheet/2/447/KEM_C1006_X5R_SMD-3316465.pdf | N | 100V | NP0/C0G
Kemet | C0402C102G5GACTU | 1n | N | 0402 | Capacitor_SMD:C_0402_1005Metric | 0.5 | 2% | https://www.mouser.co.uk/datasheet/2/447/KEM_C1006_X5R_SMD-3316465.pdf | N | 50V | NP0/C0G
Kemet | C0402C122K4GACTU | 1n2 | N | 0402 | Capacitor_SMD:C_0402_1005Metric | 0.5 | 10% | https://www.mouser.co.uk/datasheet/2/447/KEM_C1006_X5R_SMD-3316465.pdf | N | 16V | NP0/C0G
Kemet | C0402C101K2GACTU | 100p | N | 0402 | Capacitor_SMD:C_0402_1005Metric | 0.5 | 10% | https://www.mouser.co.uk/datasheet/2/447/KEM_C1006_X5R_SMD-3316465.pdf | N | 200V | NP0/C0G
Kemet | C0402C121J2GACTU | 120p | N | 0402 | Capacitor_SMD:C_0402_1005Metric | 0.5 | 2% | https://www.mouser.co.uk/datasheet/2/447/KEM_C1006_X5R_SMD-3316465.pdf | N | 200V | NP0/C0G
Kemet | C0402C123K9PACTU | 12n | N | 0402 | Capacitor_SMD:C_0402_1005Metric | 0.5 | 10% | https://www.mouser.co.uk/datasheet/2/447/KEM_C1006_X5R_SMD-3316465.pdf | N | 6.3V | X5R
Kemet | C0402C109D5GACTU | 1p | N | 0402 | Capacitor_SMD:C_0402_1005Metric | 0.5 | 0.5pF | https://www.mouser.co.uk/datasheet/2/447/KEM_C1006_X5R_SMD-3316465.pdf | N | 50V | NP0/C0G
Kemet | C0402C279C3GACTU | 2p7 | N | 0402 | Capacitor_SMD:C_0402_1005Metric | 0.5 | 0.25pF | https://www.mouser.co.uk/datasheet/2/447/KEM_C1006_X5R_SMD-3316465.pdf | N | 25V | NP0/C0G
Kemet | C0402C271G5GACTU | 270p | N | 0402 | Capacitor_SMD:C_0402_1005Metric | 0.5 | 2% | https://www.mouser.co.uk/datasheet/2/447/KEM_C1006_X5R_SMD-3316465.pdf | N | 50V | NP0/C0G
Kemet | C0402C101J2GACTU | 100p | N | 0402 | Capacitor_SMD:C_0402_1005Metric | 0.5 | 2% | https://www.mouser.co.uk/datasheet/2/447/KEM_C1006_X5R_SMD-3316465.pdf | N | 200V | NP0/C0G
Kemet | C0402C829B5GACTU | 8p2 | N | 0402 | Capacitor_SMD:C_0402_1005Metric | 0.5 | 0.1pF | https://www.mouser.co.uk/datasheet/2/447/KEM_C1006_X5R_SMD-3316465.pdf | N | 50V | NP0/C0G
Kemet | C0402C430J3GACTU | 43p | N | 0402 | Capacitor_SMD:C_0402_1005Metric | 0.5 | 2% | https://www.mouser.co.uk/datasheet/2/447/KEM_C1006_X5R_SMD-3316465.pdf | N | 25V | NP0/C0G
Kemet | C0402C561K5GACTU | 560p | N | 0402 | Capacitor_SMD:C_0402_1005Metric | 0.5 | 10% | https://www.mouser.co.uk/datasheet/2/447/KEM_C1006_X5R_SMD-3316465.pdf | N | 50V | NP0/C0G
Kemet | C0402C390J8GACTU | 39p | N | 0402 | Capacitor_SMD:C_0402_1005Metric | 0.5 | 2% | https://www.mouser.co.uk/datasheet/2/447/KEM_C1006_X5R_SMD-3316465.pdf | N | 10V | NP0/C0G
Kemet | C0402C224M9PACTU | 220n | N | 0402 | Capacitor_SMD:C_0402_1005Metric | 0.5 | 20% | https://www.mouser.co.uk/datasheet/2/447/KEM_C1006_X5R_SMD-3316465.pdf | N | 6.3V | X5R
Kemet | C0402C680K4GACTU | 68p | N | 0402 | Capacitor_SMD:C_0402_1005Metric | 0.5 | 10% | https://www.mouser.co.uk/datasheet/2/447/KEM_C1006_X5R_SMD-3316465.pdf | N | 16V | NP0/C0G
Kemet | C0402C221J2GACTU | 220p | N | 0402 | Capacitor_SMD:C_0402_1005Metric | 0.5 | 2% | https://www.mouser.co.uk/datasheet/2/447/KEM_C1006_X5R_SMD-3316465.pdf | N | 200V | NP0/C0G
Kemet | C0402C519B5GACTU | 5p1 | N | 0402 | Capacitor_SMD:C_0402_1005Metric | 0.5 | 0.1pF | https://www.mouser.co.uk/datasheet/2/447/KEM_C1006_X5R_SMD-3316465.pdf | N | 50V | NP0/C0G
Kemet | C0402C301J5GACTU | 300p | N | 0402 | Capacitor_SMD:C_0402_1005Metric | 0.5 | 2% | https://www.mouser.co.uk/datasheet/2/447/KEM_C1006_X5R_SMD-3316465.pdf | N | 50V | NP0/C0G
Kemet | C0402C331F5GACTU | 330p | N | 0402 | Capacitor_SMD:C_0402_1005Metric | 0.5 | 1% | https://www.mouser.co.uk/datasheet/2/447/KEM_C1006_X5R_SMD-3316465.pdf | N | 50V | NP0/C0G
Kemet | C0402C330J4GACTU | 33p | N | 0402 | Capacitor_SMD:C_0402_1005Metric | 0.5 | 2% | https://www.mouser.co.uk/datasheet/2/447/KEM_C1006_X5R_SMD-3316465.pdf | N | 16V | NP0/C0G
Kemet | C0402C100C5GACTU | 10p | N | 0402 | Capacitor_SMD:C_0402_1005Metric | 0.5 | 0.25pF | https://www.mouser.co.uk/datasheet/2/447/KEM_C1006_X5R_SMD-3316465.pdf | N | 50V | NP0/C0G
Kemet | C0402C561F3GACTU | 560p | N | 0402 | Capacitor_SMD:C_0402_1005Metric | 0.5 | 1% | https://www.mouser.co.uk/datasheet/2/447/KEM_C1006_X5R_SMD-3316465.pdf | N | 25V | NP0/C0G
Kemet | C0402C131J5GACTU | 130p | N | 0402 | Capacitor_SMD:C_0402_1005Metric | 0.5 | 2% | https://www.mouser.co.uk/datasheet/2/447/KEM_C1006_X5R_SMD-3316465.pdf | N | 50V | NP0/C0G
Kemet | C0402C330G5GACTU | 33p | N | 0402 | Capacitor_SMD:C_0402_1005Metric | 0.5 | 2% | https://www.mouser.co.uk/datasheet/2/447/KEM_C1006_X5R_SMD-3316465.pdf | N | 50V | NP0/C0G
Kemet | C0402C511J5GACTU | 510p | N | 0402 | Capacitor_SMD:C_0402_1005Metric | 0.5 | 2% | https://www.mouser.co.uk/datasheet/2/447/KEM_C1006_X5R_SMD-3316465.pdf | N | 50V | NP0/C0G
Kemet | C0402C339D3GACTU | 3p3 | N | 0402 | Capacitor_SMD:C_0402_1005Metric | 0.5 | 0.5pF | https://www.mouser.co.uk/datasheet/2/447/KEM_C1006_X5R_SMD-3316465.pdf | N | 25V | NP0/C0G
Kemet | C0402C129D4GACTU | 1p2 | N | 0402 | Capacitor_SMD:C_0402_1005Metric | 0.5 | 0.5pF | https://www.mouser.co.uk/datasheet/2/447/KEM_C1006_X5R_SMD-3316465.pdf | N | 16V | NP0/C0G
Kemet | C0402C430F5GACTU | 43p | N | 0402 | Capacitor_SMD:C_0402_1005Metric | 0.5 | 1% | https://www.mouser.co.uk/datasheet/2/447/KEM_C1006_X5R_SMD-3316465.pdf | N | 50V | NP0/C0G
Kemet | C0402C560J8GACTU | 56p | N | 0402 | Capacitor_SMD:C_0402_1005Metric | 0.5 | 2% | https://www.mouser.co.uk/datasheet/2/447/KEM_C1006_X5R_SMD-3316465.pdf | N | 10V | NP0/C0G
Kemet | C0402C109C3GACTU | 1p | N | 0402 | Capacitor_SMD:C_0402_1005Metric | 0.5 | 0.25pF | https://www.mouser.co.uk/datasheet/2/447/KEM_C1006_X5R_SMD-3316465.pdf | N | 25V | NP0/C0G
Kemet | C0402C390G5GACTU | 39p | N | 0402 | Capacitor_SMD:C_0402_1005Metric | 0.5 | 2% | https://www.mouser.co.uk/datasheet/2/447/KEM_C1006_X5R_SMD-3316465.pdf | N | 50V | NP0/C0G
Kemet | C0402C629J5GACTU | 6p2 | N | 0402 | Capacitor_SMD:C_0402_1005Metric | 0.5 | 2% | https://www.mouser.co.uk/datasheet/2/447/KEM_C1006_X5R_SMD-3316465.pdf | N | 50V | NP0/C0G
Kemet | C0402C121F5GACTU | 120p | N | 0402 | Capacitor_SMD:C_0402_1005Metric | 0.5 | 1% | https://www.mouser.co.uk/datasheet/2/447/KEM_C1006_X5R_SMD-3316465.pdf | N | 50V | NP0/C0G
Kemet | C0402C680F3GACTU | 68p | N | 0402 | Capacitor_SMD:C_0402_1005Metric | 0.5 | 1% | https://www.mouser.co.uk/datasheet/2/447/KEM_C1006_X5R_SMD-3316465.pdf | N | 25V | NP0/C0G
Kemet | C0402C104K3PACTU | 100n | N | 0402 | Capacitor_SMD:C_0402_1005Metric | 0.5 | 10% | https://www.mouser.co.uk/datasheet/2/447/KEM_C1006_X5R_SMD-3316465.pdf | N | 25V | X5R
Kemet | C0402C225K9PACTU | 2u2 | N | 0402 | Capacitor_SMD:C_0402_1005Metric | 0.5 | 10% | https://www.mouser.co.uk/datasheet/2/447/KEM_C1006_X5R_SMD-3316465.pdf | N | 6.3V | X5R
Kemet | C0402C200F5GACTU | 20p | N | 0402 | Capacitor_SMD:C_0402_1005Metric | 0.5 | 1% | https://www.mouser.co.uk/datasheet/2/447/KEM_C1006_X5R_SMD-3316465.pdf | N | 50V | NP0/C0G
Kemet | C0402C152J5GACTU | 1n5 | N | 0402 | Capacitor_SMD:C_0402_1005Metric | 0.5 | 2% | https://www.mouser.co.uk/datasheet/2/447/KEM_C1006_X5R_SMD-3316465.pdf | N | 50V | NP0/C0G
Kemet | C0402C472K5RACTU | 4n7 | N | 0402 | Capacitor_SMD:C_0402_1005Metric | 0.5 | 10% | https://www.mouser.co.uk/datasheet/2/447/KEM_C1002_X7R_SMD-3316098.pdf | N | 50V | X7R
Kyocera AVX | 1206DD106MAT2A | 10u | N | 1206 | Capacitor_SMD:C_1206_3216Metric | 1.9 | 20% | https://www.mouser.co.uk/datasheet/2/40/cx5r_KGM-3223198.pdf | N | 35V | X5R
TDK | C3216X5R1E476M160AC | 47u | N | 1206 | Capacitor_SMD:C_1206_3216Metric | 1.6 | 20% | https://product.tdk.com/system/files/dam/doc/product/capacitor/ceramic/mlcc/catalog/mlcc_commercial_general_en.pdf | N | 25V | X5R
Murata | GRM1552C1H102GA01 | 1n | N | 0402 | Capacitor_SMD:C_0402_1005Metric | 0.55 | 2% |  | N | 50V | CH
Murata | GRM1552C1H102JA01 | 1n | N | 0402 | Capacitor_SMD:C_0402_1005Metric | 0.55 | 5% |  | N | 50V | CH
Murata | GRM1552C1H271GA01 | 270p | N | 0402 | Capacitor_SMD:C_0402_1005Metric | 0.55 | 2% |  | N | 50V | CH
Murata | GRM1552C1H271JA01 | 270p | N | 0402 | Capacitor_SMD:C_0402_1005Metric | 0.55 | 5% |  | N | 50V | CH
Murata | GRM1552C1H331GA01 | 330p | N | 0402 | Capacitor_SMD:C_0402_1005Metric | 0.55 | 2% |  | N | 50V | CH
Murata | GRM1552C1H331JA01 | 330p | N | 0402 | Capacitor_SMD:C_0402_1005Metric | 0.55 | 5% |  | N | 50V | CH
Murata | GRM1552C1H391GA01 | 390p | N | 0402 | Capacitor_SMD:C_0402_1005Metric | 0.55 | 2% |  | N | 50V | CH
Murata | GRM1552C1H391JA01 | 390p | N | 0402 | Capacitor_SMD:C_0402_1005Metric | 0.55 | 5% |  | N | 50V | CH
Murata | GRM1552C1H471GA01 | 470p | N | 0402 | Capacitor_SMD:C_0402_1005Metric | 0.55 | 2% |  | N | 50V | CH
Murata | GRM1552C1H471JA01 | 470p | N | 0402 | Capacitor_SMD:C_0402_1005Metric | 0.55 | 5% |  | N | 50V | CH
Murata | GRM1552C1H561GA01 | 560p | N | 0402 | Capacitor_SMD:C_0402_1005Metric | 0.55 | 2% |  | N | 50V | CH
Murata | GRM1552C1H561JA01 | 560p | N | 0402 | Capacitor_SMD:C_0402_1005Metric | 0.55 | 5% |  | N | 50V | CH
Murata | GRM1552C1H681GA01 | 680p | N | 0402 | Capacitor_SMD:C_0402_1005Metric | 0.55 | 2% |  | N | 50V | CH
Murata | GRM1552C1H681JA01 | 680p | N | 0402 | Capacitor_SMD:C_0402_1005Metric | 0.55 | 5% |  | N | 50V | CH
Murata | GRM1552C1H821GA01 | 820p | N | 0402 | Capacitor_SMD:C_0402_1005Metric | 0.55 | 2% |  | N | 50V | CH
Murata | GRM1552C1H821JA01 | 820p | N | 0402 | Capacitor_SMD:C_0402_1005Metric | 0.55 | 5% |  | N | 50V | CH
Murata | GRM1553U1A242JA01 | 2n4 | N | 0402 | Capacitor_SMD:C_0402_1005Metric | 0.55 | 5% |  | N | 10V | UJ
Murata | GRM1553U1A272JA01 | 2n7 | N | 0402 | Capacitor_SMD:C_0402_1005Metric | 0.55 | 5% |  | N | 10V | UJ
Murata | GRM1553U1A302JA01 | 3n | N | 0402 | Capacitor_SMD:C_0402_1005Metric | 0.55 | 5% |  | N | 10V | UJ
Murata | GRM1553U1A332JA01 | 3n3 | N | 0402 | Capacitor_SMD:C_0402_1005Metric | 0.55 | 5% |  | N | 10V | UJ
Murata | GRM1553U1A362JA01 | 3n6 | N | 0402 | Capacitor_SMD:C_0402_1005Metric | 0.55 | 5% |  | N | 10V | UJ
Murata | GRM1553U1A392JA01 | 3n9 | N | 0402 | Capacitor_SMD:C_0402_1005Metric | 0.55 | 5% |  | N | 10V | UJ
Murata | GRM1553U1A432JA01 | 4n3 | N | 0402 | Capacitor_SMD:C_0402_1005Metric | 0.55 | 5% |  | N | 10V | UJ
Murata | GRM1553U1A472JA01 | 4n7 | N | 0402 | Capacitor_SMD:C_0402_1005Metric | 0.55 | 5% |  | N | 10V | UJ
Murata | GRM1555C1E103GE01 | 10n | N | 0402 | Capacitor_SMD:C_0402_1005Metric | 0.65 | 2% |  | N | 25V | C0G
Murata | GRM1555C1E103JE01 | 10n | N | 0402 | Capacitor_SMD:C_0402_1005Metric | 0.65 | 5% |  | N | 25V | C0G
Murata | GRM1555C1H100GA01 | 10p | N | 0402 | Capacitor_SMD:C_0402_1005Metric | 0.55 | 2% |  | N | 50V | C0G
Murata | GRM1555C1H100JA01 | 10p | N | 0402 | Capacitor_SMD:C_0402_1005Metric | 0.55 | 5% |  | N | 50V | C0G
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
Murata | GRM1555C1H270JA01 | 27p | N | 0402 | Capacitor_SMD:C_0402_1005Metric | 0.55 | 5% |  | N | 50V | C0G
Murata | GRM1555C1H271FA01 | 270p | N | 0402 | Capacitor_SMD:C_0402_1005Metric | 0.55 | 1% |  | N | 50V | C0G
Murata | GRM1555C1H271GA01 | 270p | N | 0402 | Capacitor_SMD:C_0402_1005Metric | 0.55 | 2% |  | N | 50V | C0G
Murata | GRM1555C1H271JA01 | 270p | N | 0402 | Capacitor_SMD:C_0402_1005Metric | 0.55 | 5% |  | N | 50V | C0G
Murata | GRM1555C1H272GE01 | 2n7 | N | 0402 | Capacitor_SMD:C_0402_1005Metric | 0.55 | 2% |  | N | 50V | C0G
Murata | GRM1555C1H272JE01 | 2n7 | N | 0402 | Capacitor_SMD:C_0402_1005Metric | 0.55 | 5% |  | N | 50V | C0G
Murata | GRM1555C1H2R2BA01 | 2p2 | N | 0402 | Capacitor_SMD:C_0402_1005Metric | 0.55 | 0.1p |  | N | 50V | C0G
Murata | GRM1555C1H2R2CA01 | 2p2 | N | 0402 | Capacitor_SMD:C_0402_1005Metric | 0.55 | 0.25p |  | N | 50V | C0G
Murata | GRM1555C1H2R7BA01 | 2p7 | N | 0402 | Capacitor_SMD:C_0402_1005Metric | 0.55 | 0.1p |  | N | 50V | C0G
Murata | GRM1555C1H2R7CA01 | 2p7 | N | 0402 | Capacitor_SMD:C_0402_1005Metric | 0.55 | 0.25p |  | N | 50V | C0G
Murata | GRM1555C1H330GA01 | 33p | N | 0402 | Capacitor_SMD:C_0402_1005Metric | 0.55 | 2% |  | N | 50V | C0G
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
