M0WUT/kicad_libraries/(commit log)

2019-09-05 added 3d model for powerpole
2021-06-28 Added DIN41612 connectors
2021-09-24 Added FMC LPC template
    [FMC_LPC.kicad_pcb, FMC_LPC.kicad_sch, fmcConnector.kicad_sch]
2023-08-08 big move towards auto-generated libraries
    [autogenerated_capacitors.csv, autogenerated_inductors.csv]
2023-08-09 Moved all generics to single csv
    [autogenerated_capacitors.csv, autogenerated_inductors.csv, autogenerated_parts.csv]
2023-08-11 Moved KOA resistors into main scripts
    [autogenerated_parts.csv, autogenerated_parts.xlsx]
2023-10-25 Added KEmet 0402
    [autogenerated_parts.xlsx]
2023-11-06 Moved TVS diodes into autogenerated
    [autogenerated_parts.xlsx]
2025-10-19 broke out parts spreadsheet
    [autogenerated_parts.xlsx, autogenerated_parts_backup.xlsx]
2025-10-26 New system actually works now
    [FMC_LPC.kicad_pcb, autogenerated_parts.xlsx, autogenerated_parts_backup.xlsx]
